fontysrobotics/DCRC/Physical_System/Solidworks_Parts/Renders/exploded view.jpg

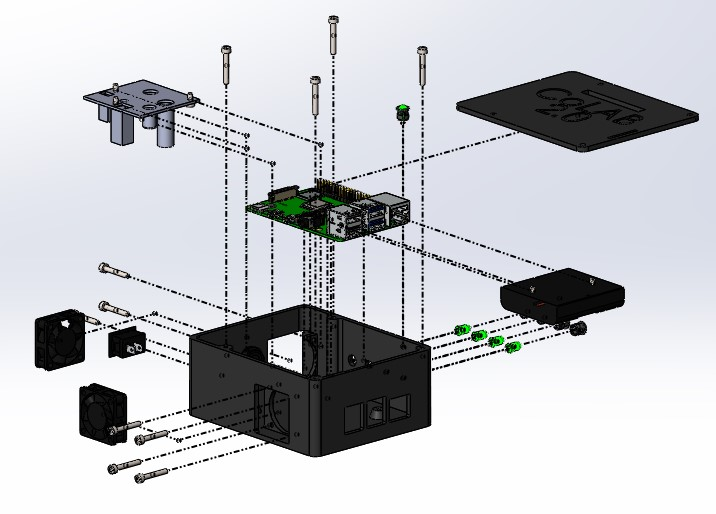
Physical_System/Solidworks_Parts/Renders/exploded view.jpg
