fontysrobotics/DCRC/Reports/Obstacle Avoidance System.pdf

# Obstacle/Crash Avoidance Feature

## DCRC Project

## Safety Course Level 3

Background and Current Situation are explained in previous document!

Execution:

The obstacle avoidance feature was created in order to recognize if there is going to be a crash between two robots and prevent it. Because this goal is too broad, I have set the scope together with our project mentor Pablo as follows:

Two robots are facing each other and going in each other’s direction along the X axis.

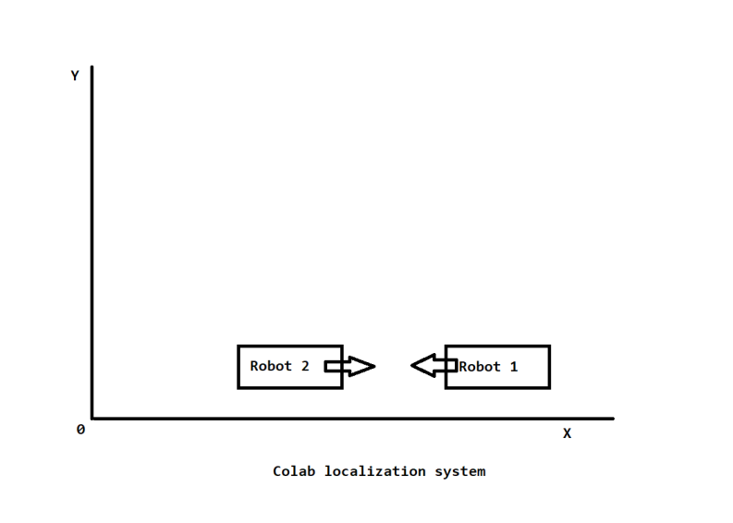
[picture p30: figure]

The goal of the test case is to detect an obstacle via the lidar and compare the lidar data to the colab list of AGVs, which contains the distance to each AGV and the angle to each of them. So each robot has that list and knows the distance to all the other and the angle to all the other. By comparing that to the lidar we know if what is in front of us is actually a robot and which exact robot it is. When the robots “see” that there is another robot in front of them they stop and compare their tasks’ priorities. The robot with the higher priority waits and the one with the lower gets a new goal to move along the Y axis so it can get out of the way. After the robot with the lower priority task gets out of the way the other robot continues on its path and the robot with the lower priority is given back its original goal and it continues on its way. In this way we prevent a crash and have a system for managing robot coordination for that particular test case.

The way the feature works is that the robots are subscribed to their Lidar and get the data of their surroundings. Because I defined the test case as the two robots facing each other, in the Lidar callback method I check if the distance to the nearest object at the 0th angle is less than 5 centimeters, meaning that we check for an obstacle in front of the robot that is nearer than half a meter. Once we find such an obstacle, the robot has to define if the obstacle in front of it is another robot and that is done by getting the list of AGVs from the colab localization software via TCP and filtering those, which are in radius of 0.5 meters. After that the robot checks if the robots that are in this radius are within a 5 degrees range of the front of the robot to filter the list further. If there is a robot in that satisfies those two conditions then the conclusion is that the obstacle in front is a robot. In order to prevent a crash the robots uses the emergency stop to pause its task and stop in place. After that the robot gets the priority of the task of the robot in front of it and its own task priority, which is done with the help of topics. The information about the priorities comes from the blackboard and if the robot has a greater priority than the one in front of it, it waits for a while. If the robot has a lower priority than the one in front of it then it is given a new temporary goal to move along the Y axis in order to make space for the other robot to pass. After it has reached the temporary goal then the robot is given again its original goal and it continues on its path and in that way both robots have avoided a crash. The sequence diagram and screenshots of the code can be seen below:

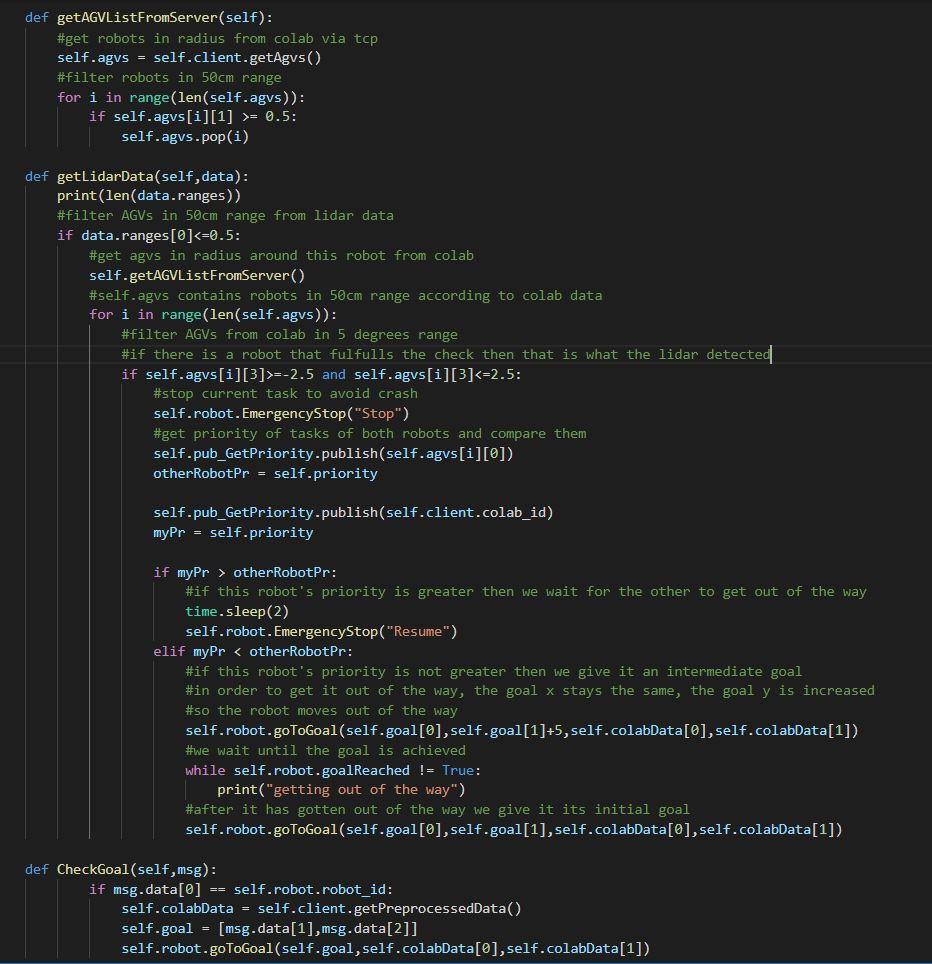
[picture p31: figure]

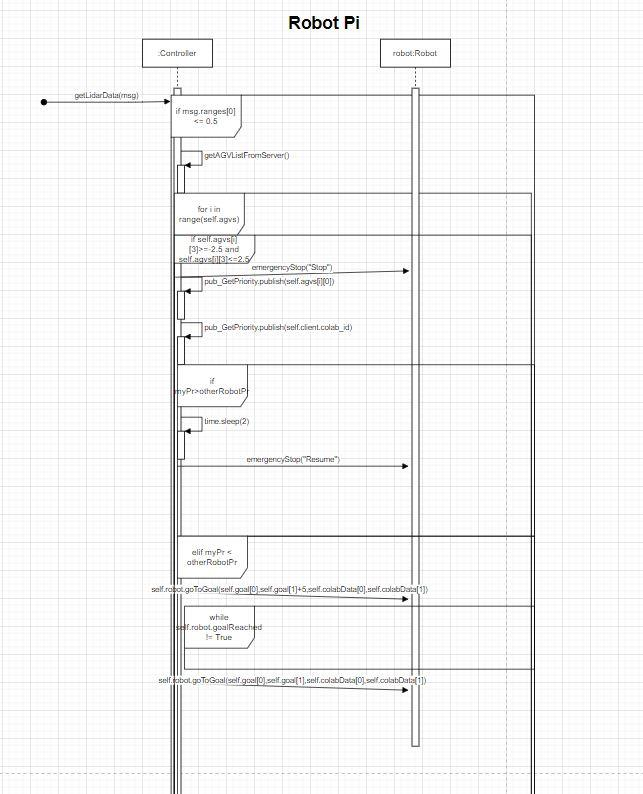
[picture p32: figure]

Result:

As I explained in the previous document, the current situation is such that the robot navigation to goal is not working on Ubuntu with ros and only works on raspbian. Furthermore, the ros bridge and ssh are not working so it is not possible to assign a task to robot. This feature too cannot be tested as in order to test even a basic version of it I will need ros2 for the lidar topic and robot navigation. This is impossible because the navigation doesn’t work on ros2 and I can’t get the lidar data without ros2 so it is a deadlock. What I decided to do in order to at least show some basic prototype is to simulate it in gazebo. I successfully got the lidar data but I couldn’t publish messages on /cmd_vel to the turtlebot3 for some reason and therefore I couldn’t make it move aside to make space for the other robot. I am confident that with a bit of debugging, the feature can be easily implemented once the issues with the GPIO library and ros are solved.

The full code for the feature can be found on: https://github.com/fontysrobotics/DCRC / The feature is only on the RobotPi branch / The TCP server and client I created can also be found in the GIT repository
