fontysrobotics/DCRC/Reports/CoLAB_StrucTree_DCRC_V2_MaxJans_3497046.png

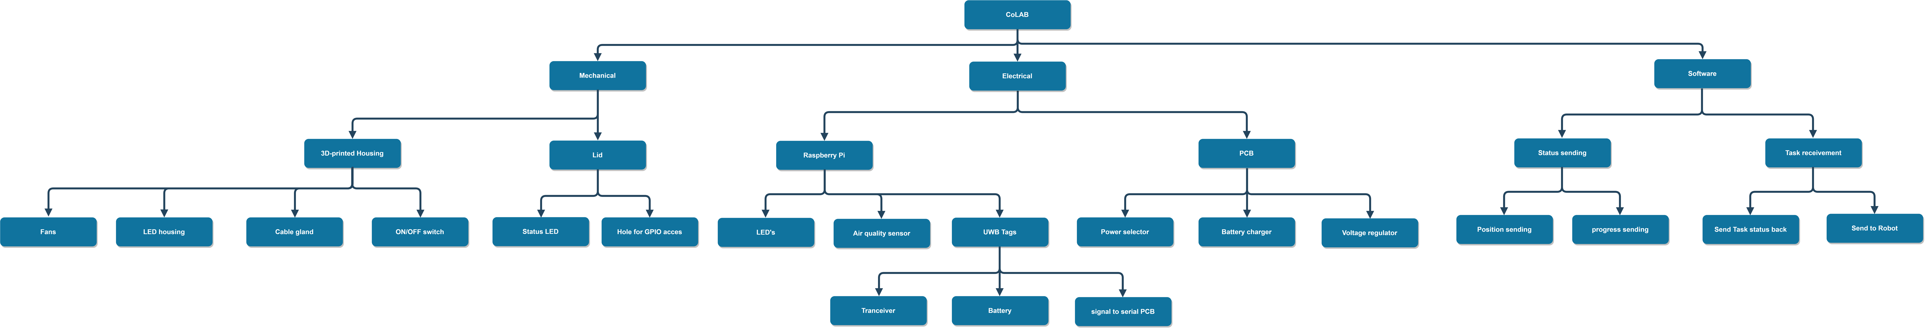
Reports/CoLAB_StrucTree_DCRC_V2_MaxJans_3497046.png
