fontysrobotics/DCRC/Wiki-Pictures/CoLAB_V2.2_PCB.png

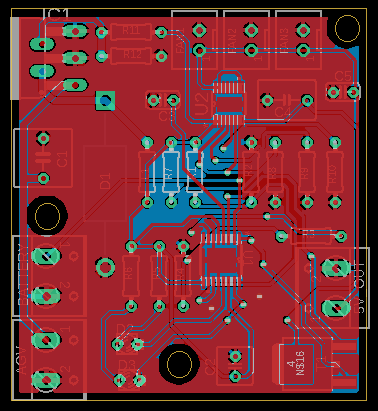
Wiki-Pictures/CoLAB_V2.2_PCB.png
