fontysrobotics/DCRC/Wiki-Pictures/CoLAB_V2_Housing.JPG

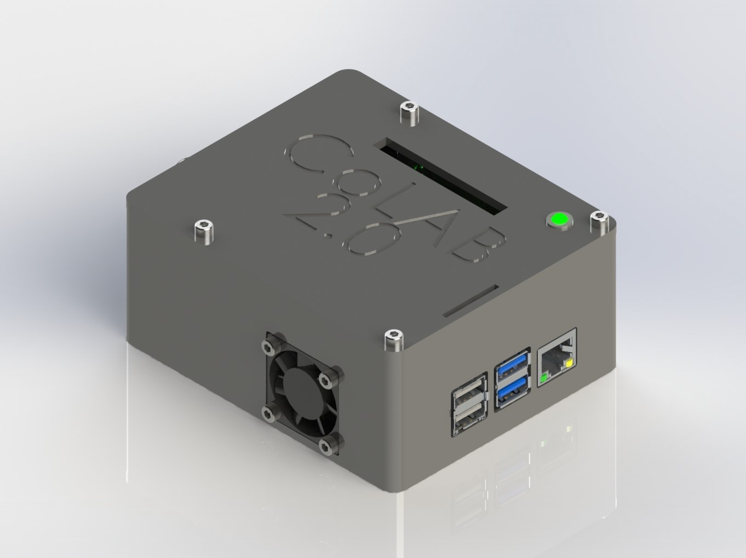
Wiki-Pictures/CoLAB_V2_Housing.JPG
