fontysrobotics/DCRC/Wiki-Pictures/CoLAB_V2_PCB.png

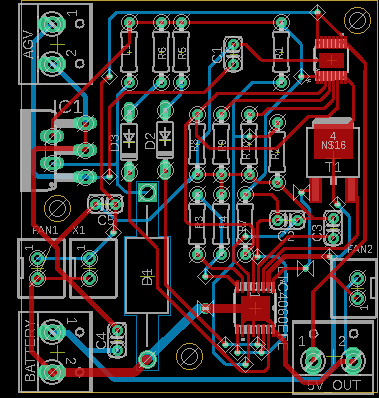
Wiki-Pictures/CoLAB_V2_PCB.png
