fontysrobotics/DCRC/Wiki-Pictures/CoLAB_V2_PCB_DC_Converter_VoltageDivider.png

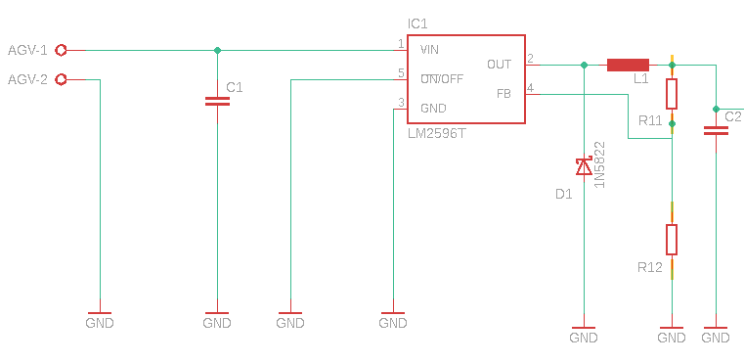
Wiki-Pictures/CoLAB_V2_PCB_DC_Converter_VoltageDivider.png
