fontysrobotics/DCRC/Wiki-Pictures/CoLAB_V2_PCB_Schematic.png

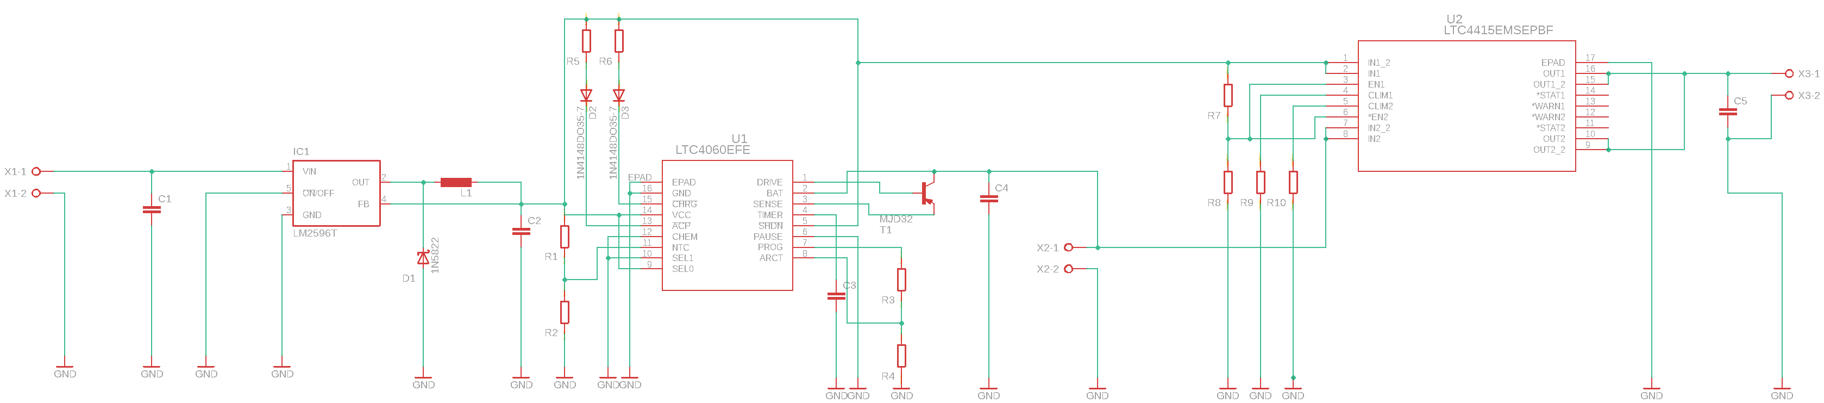
Wiki-Pictures/CoLAB_V2_PCB_Schematic.png
