fontysrobotics/DCRC/Wiki-Pictures/EmergencyStopSeqDiagram.JPG

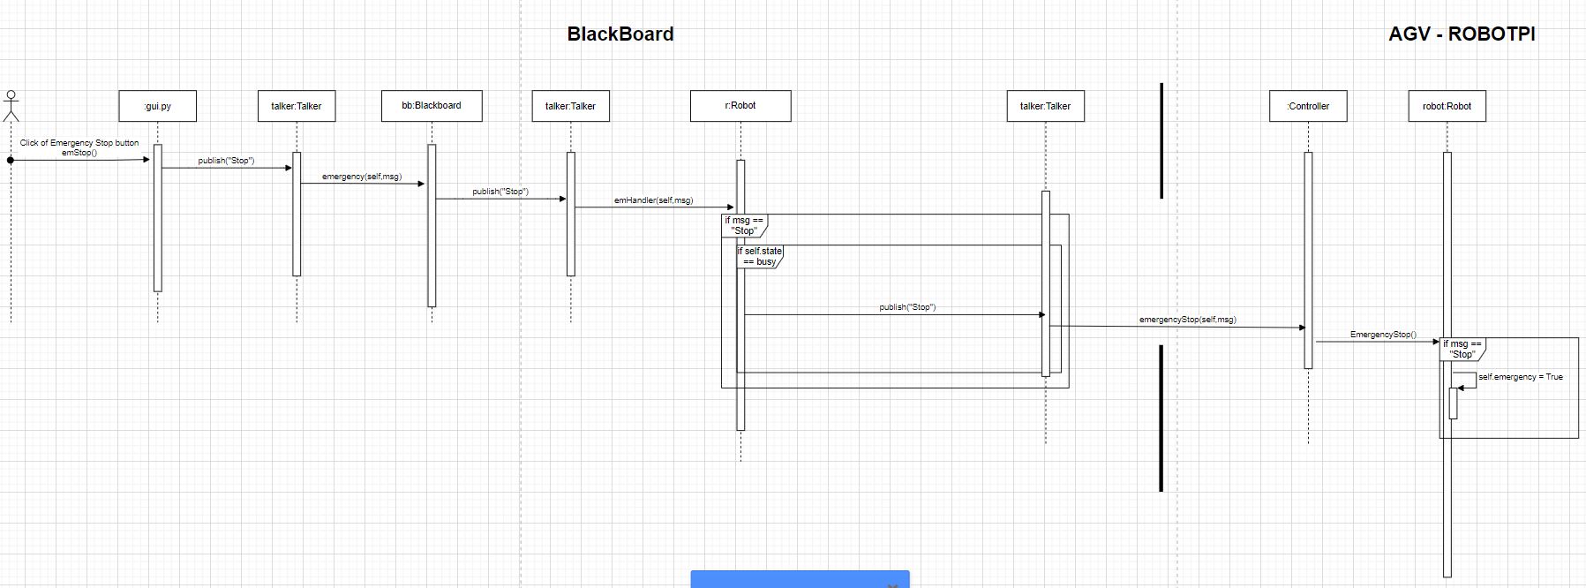
Wiki-Pictures/EmergencyStopSeqDiagram.JPG
