fontysrobotics/DCRC/Wiki-Pictures/Hollonomic car.jpeg

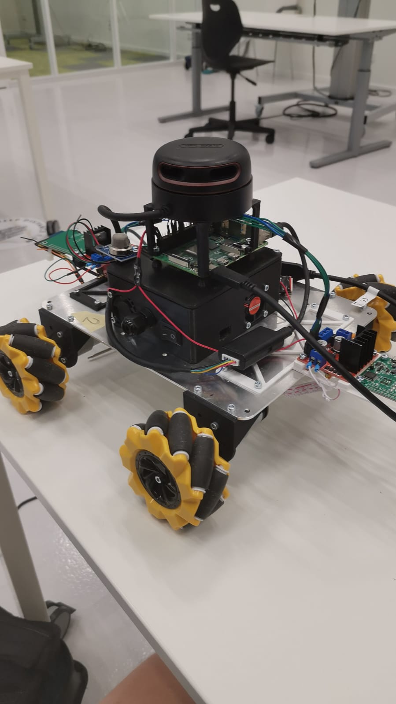
Wiki-Pictures/Hollonomic car.jpeg
