fontysrobotics/DCRC/Wiki-Pictures/ROS1 blackboard.png

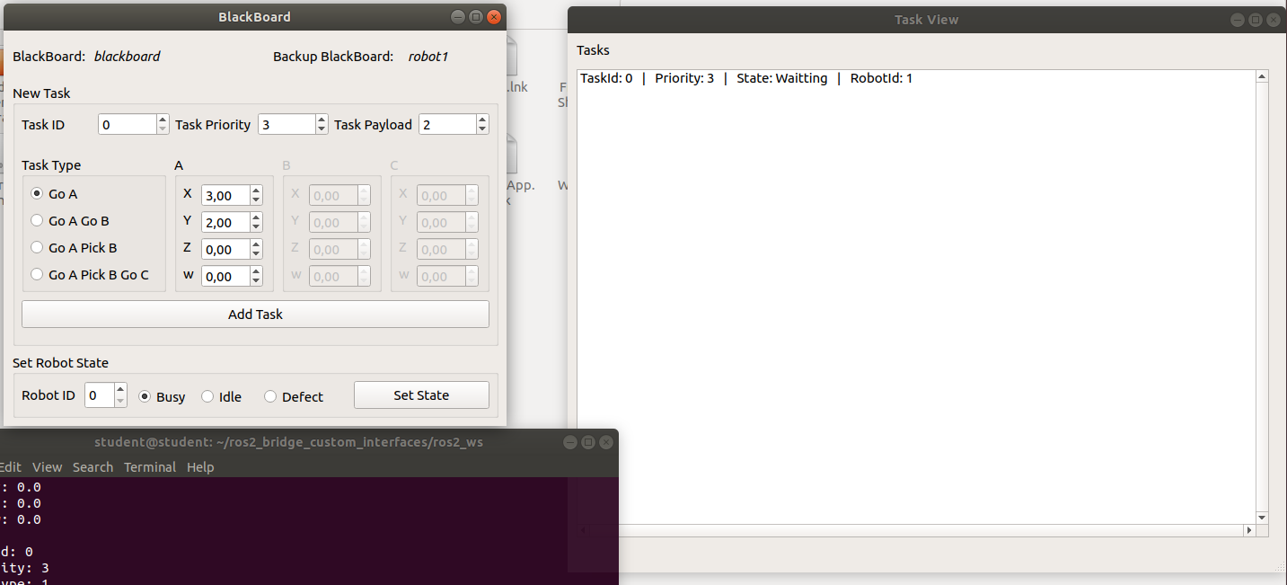
Wiki-Pictures/ROS1 blackboard.png
