fontysrobotics/DCRC/Wiki-Pictures/Ros bridge messages.png

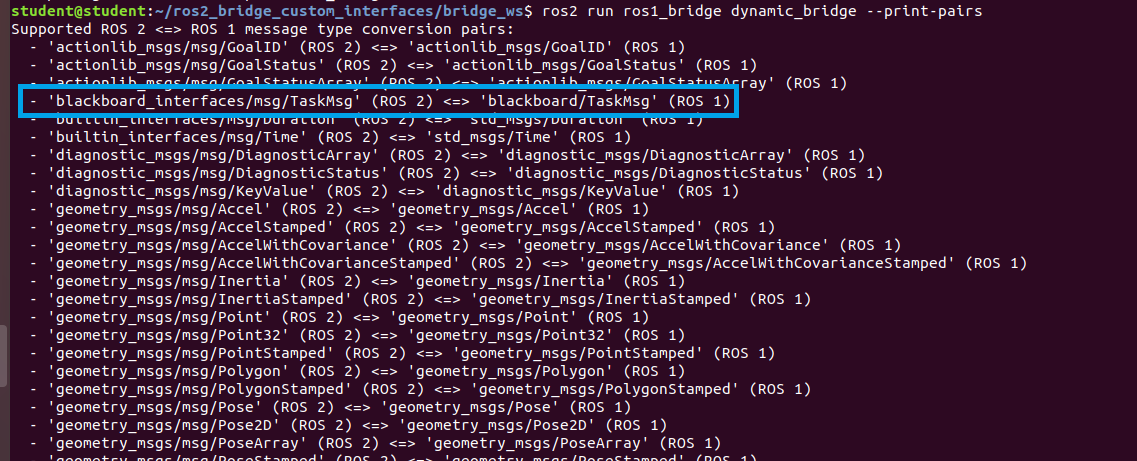
Wiki-Pictures/Ros bridge messages.png
