fontysrobotics/DCRC/Wiki-Pictures/schematic battery protection.png

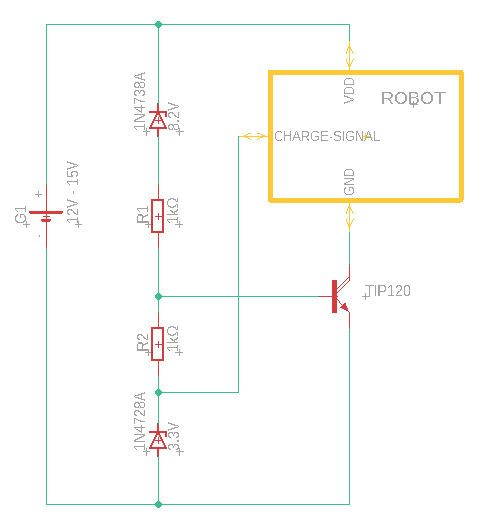
Wiki-Pictures/schematic battery protection.png
