fontysrobotics/DCRC/Wiki-Pictures/schematic LED connections.png

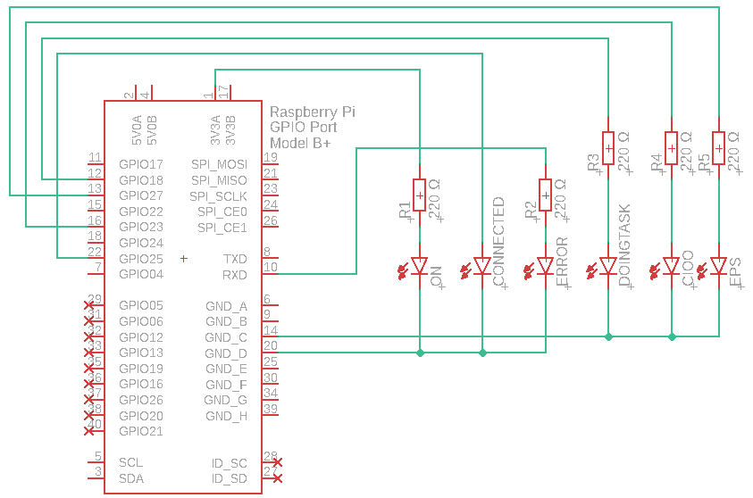
Wiki-Pictures/schematic LED connections.png
