fontysrobotics/DCRC/Physical_System/Solidworks_Parts/Renders/render colab back.JPG

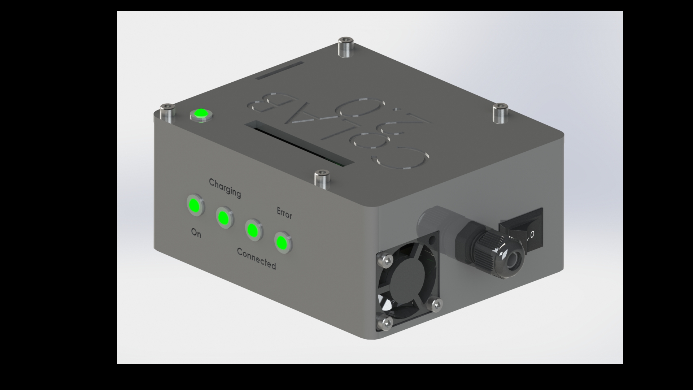
Physical_System/Solidworks_Parts/Renders/render colab back.JPG
