fontysrobotics/DCRC/Physical_System/Solidworks_Parts/Renders/render CoLAB exploded.JPG

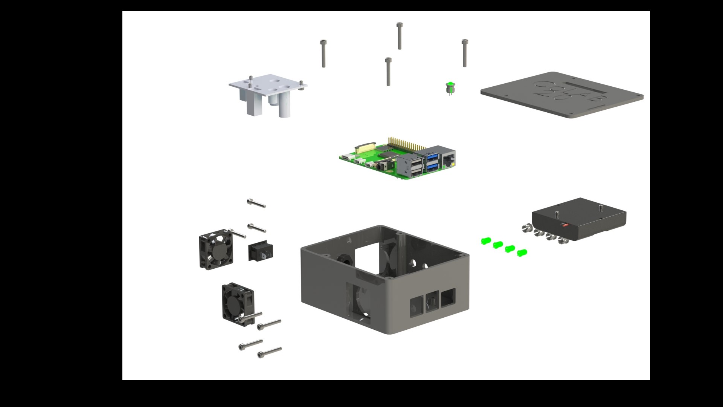
Physical_System/Solidworks_Parts/Renders/render CoLAB exploded.JPG
