fontysrobotics/DCRC/Physical_System/Solidworks_Parts/Renders/render colab front.JPG

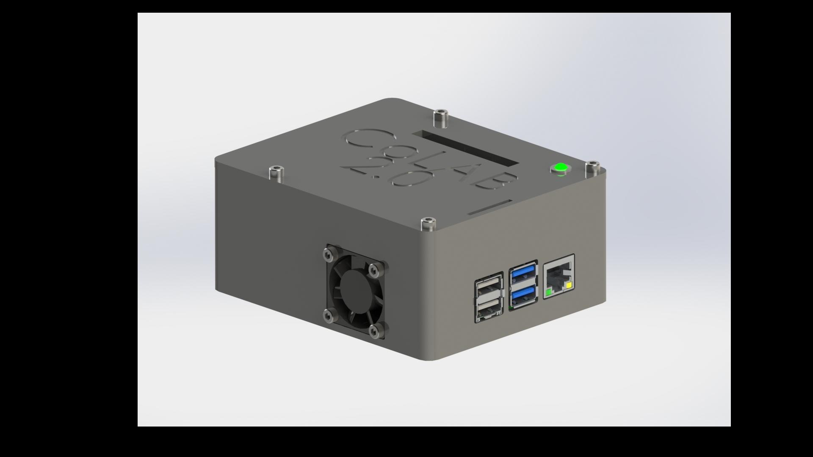
Physical_System/Solidworks_Parts/Renders/render colab front.JPG
