fontysrobotics/DCRC/Physical_System/Solidworks_Parts/Renders/render CoLAB.JPG

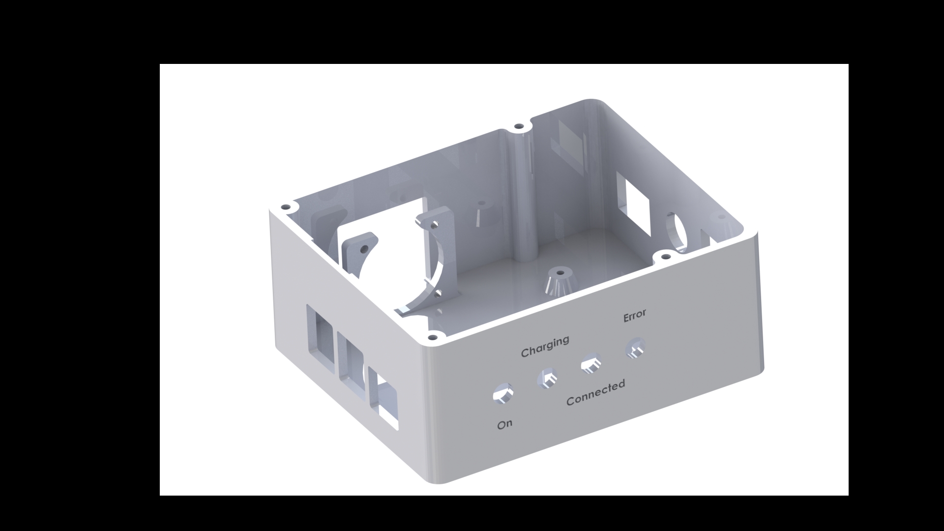
Physical_System/Solidworks_Parts/Renders/render CoLAB.JPG
