fontysrobotics/DCRC/Physical_System/Solidworks_Parts/Renders/render hole switch.JPG

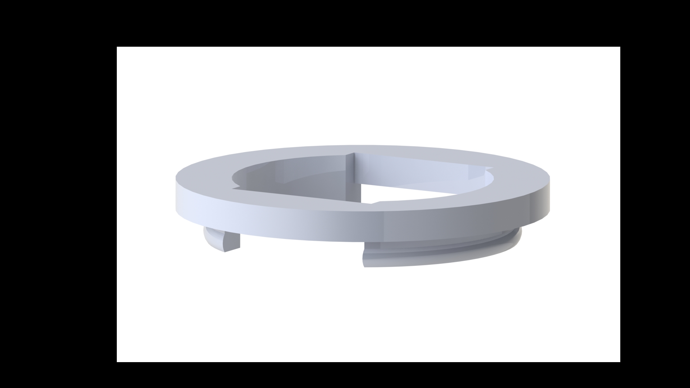
Physical_System/Solidworks_Parts/Renders/render hole switch.JPG
