fontysrobotics/DCRC/Physical_System/Solidworks_Parts/Renders/render lidar frame.JPG

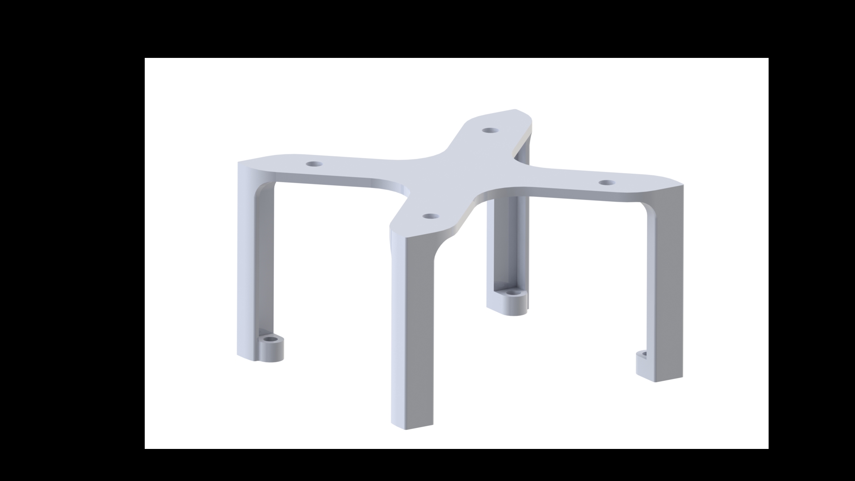
Physical_System/Solidworks_Parts/Renders/render lidar frame.JPG
