fontysrobotics/DCRC/Physical_System/Solidworks_Parts/Renders/render motor axle.JPG

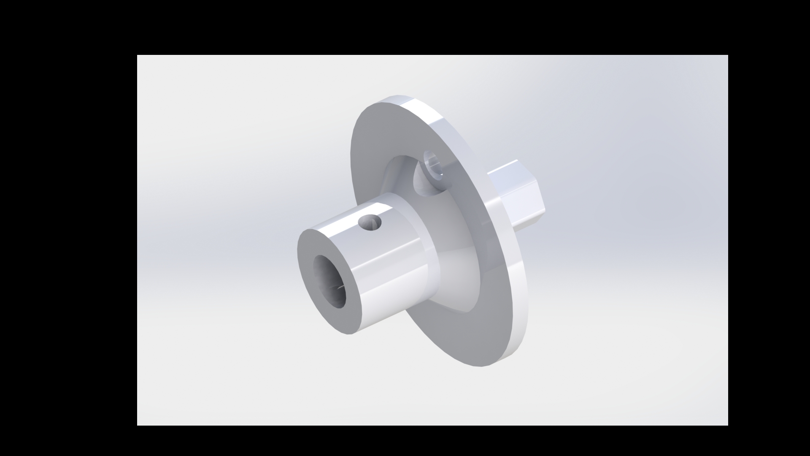
Physical_System/Solidworks_Parts/Renders/render motor axle.JPG
