fontysrobotics/DCRC/Physical_System/Solidworks_Parts/Renders/render motor mount.JPG

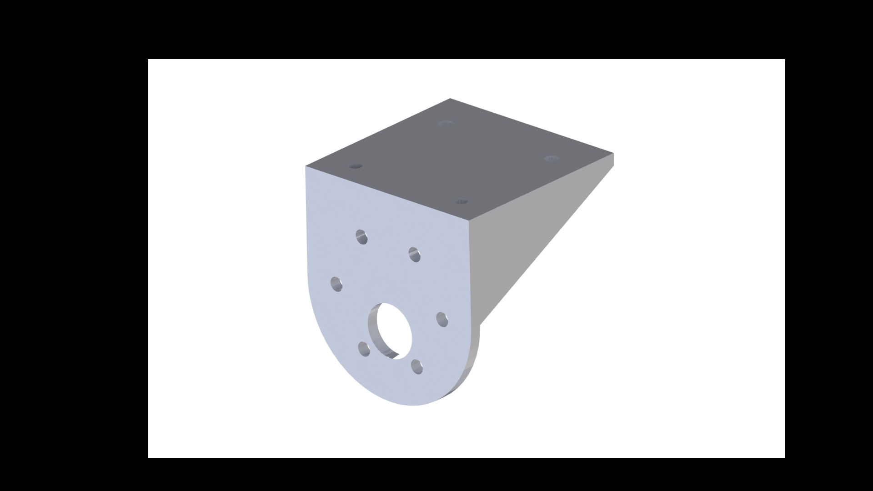
Physical_System/Solidworks_Parts/Renders/render motor mount.JPG
