fontysrobotics/DCRC/Physical_System/Solidworks_Parts/Renders/render tag holder.JPG

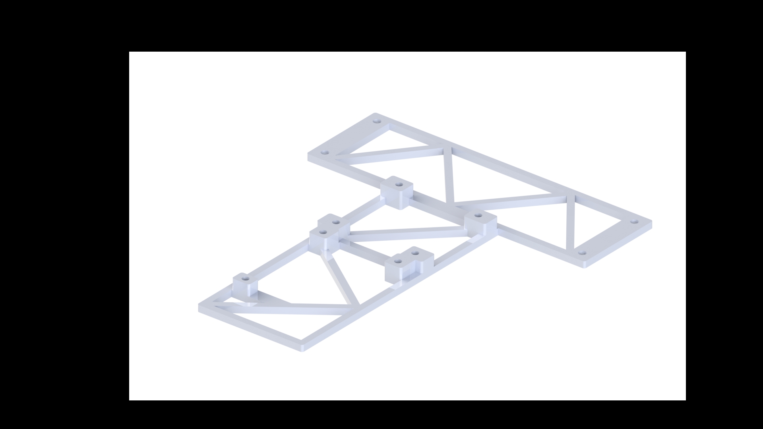
Physical_System/Solidworks_Parts/Renders/render tag holder.JPG
