fontysrobotics/DCRC/Physical_System/Solidworks_Parts/Renders/render topplate.JPG

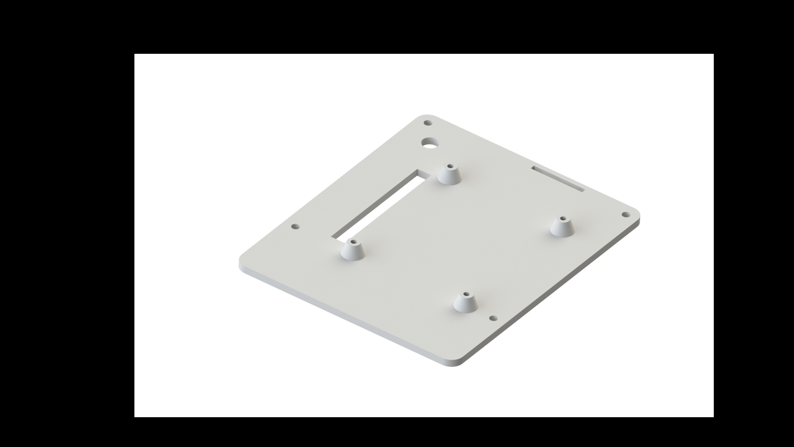
Physical_System/Solidworks_Parts/Renders/render topplate.JPG
