fontysrobotics/DCRC/Physical_System/Solidworks_Parts/CoLAB/5mm-led-grommit-1.snapshot.1/5mm-grommit-with-LED.SLDASM

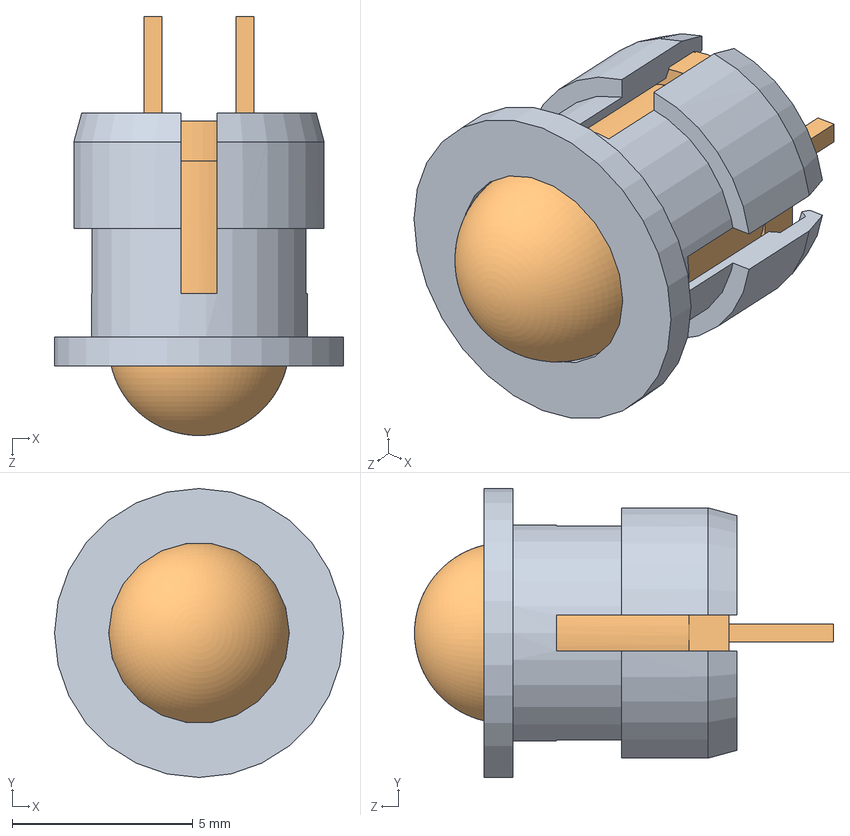
[picture p79: CAD file, 2021-07-06]
Physical_System/Solidworks_Parts/CoLAB/5mm-led-grommit-1.snapshot.1/5mm-grommit-with-LED.SLDASM
8.00 x 8.00 x 11.6 mm
5mm LED GROMMIT
Led Lamp 5 mm
