fontysrobotics/DCRC/Physical_System/Solidworks_Parts/CoLAB/led-5mm-2.snapshot.16/SolidWorks Çizimleri/Led Montaj.SLDASM

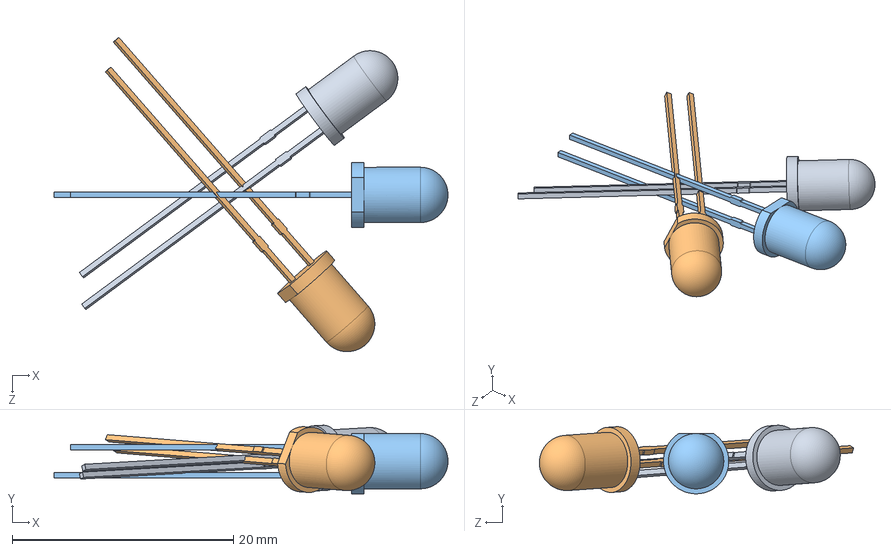
[picture p80: CAD file, 2021-07-06]
Physical_System/Solidworks_Parts/CoLAB/led-5mm-2.snapshot.16/SolidWorks Çizimleri/Led Montaj.SLDASM
35.6 x 6.19 x 28.4 mm
Led Lamp 5 mm 1(2)
Led Lamp 5 mm 2
Led Lamp 5 mm 3
