fontysrobotics/DCRC/Physical_System/Solidworks_Parts/CoLAB/CoLAB_V2_Housing.SLDASM

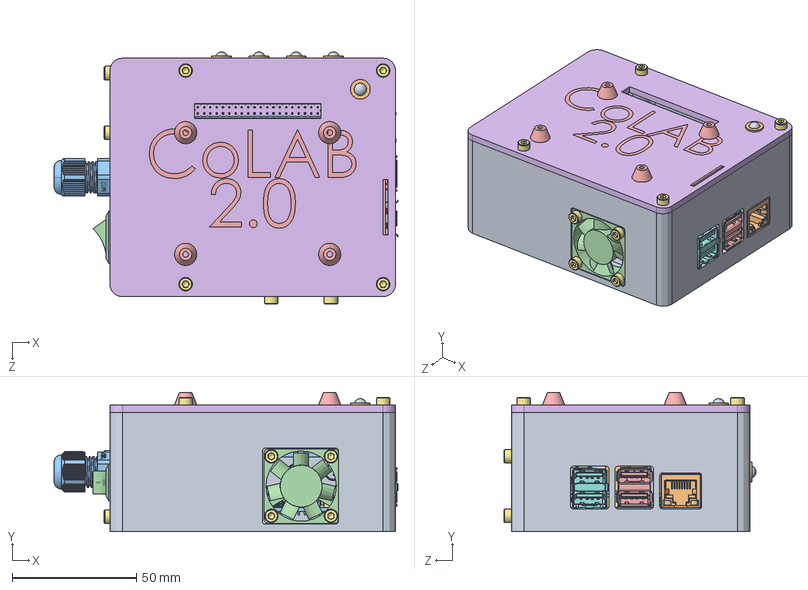
[picture p81: CAD file, 2021-07-06]
Physical_System/Solidworks_Parts/CoLAB/CoLAB_V2_Housing.SLDASM
138.5 x 56.0 x 101.5 mm
CoLAB_V2
PCBV2
Broadcom BCM2711B0 CPU, RPi4ModelB
2.54 mm DUPONT MALE PIN HEADER, POE, 2X2, RPi4ModelB
2.54 mm DUPONT MALE PIN HEADER, IO, 2X20, RPi4ModelB
Camera Connector, RPi4ModelB
Microphone Plug, RPi4ModelB
Display Connector, RPi4ModelB
Gigabit Ethernet Port, RPi4ModelB
Female Micro HDMI Connector, RPi4ModelB x 2
Female USB Type C Connector, RPi4ModelB
2X USB3.0 PORTS, RPi4ModelB
91D77 D9WHV 778K, 4 GB LPDDR4 SDRAM, RPi4ModelB
Cypress CYW43455 Wireless Module Cover, RPi4ModelB
2X USB2.0 PORTS, RPi4ModelB
Broadcom BCM54213PE Gigabit Ethernet Transceiver, RPi4ModelB
MxL7704 Universal PMIC, RPi4ModelB
AAA-battery-x4-case
30X30X10 DC fan x 2
CoLAB_Topplate_V2_GPIOacces
socket head cap screw_am x 16
socket countersunk head screw_am x 2
Led Lamp 5 mm x 5
5mm LED GROMMIT x 5
gland_m12
RockerSwitch
