fontysrobotics/DCRC/catkin_ws/src/simulation/rviz_tools_py-master/meshes/box_mesh.stl

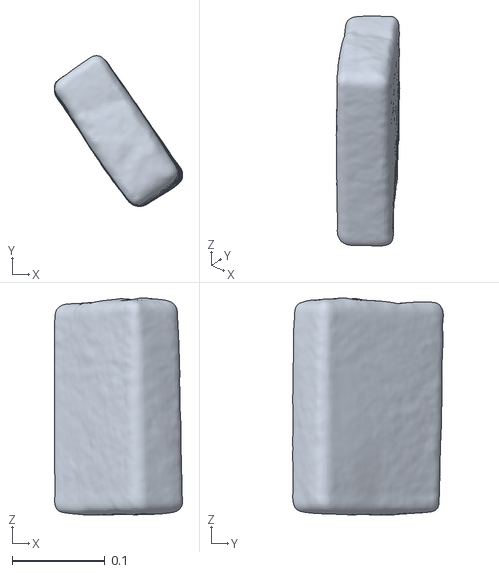
[picture p82: CAD file, 2021-07-06]
catkin_ws/src/simulation/rviz_tools_py-master/meshes/box_mesh.stl
0.139 x 0.163 x 0.234
