fontysrobotics/DCRC/catkin_ws/src/simulation/simenv/worlds/en.stl

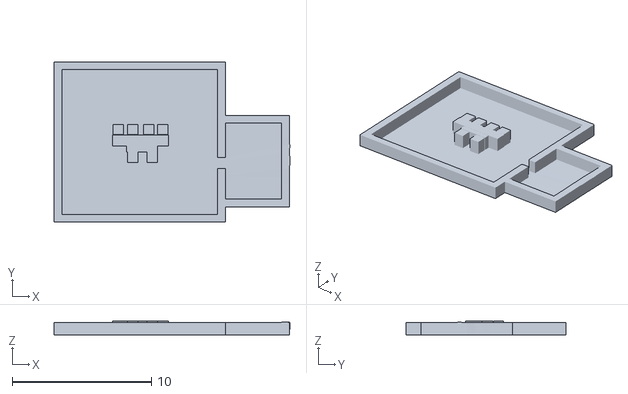
[picture p83: CAD file, 2021-07-06]
catkin_ws/src/simulation/simenv/worlds/en.stl
16.9 x 11.5 x 1.00
