fontysrobotics/DCRC/catkin_ws/src/simulation/turtlebot3_description/meshes/sensors/lds.stl

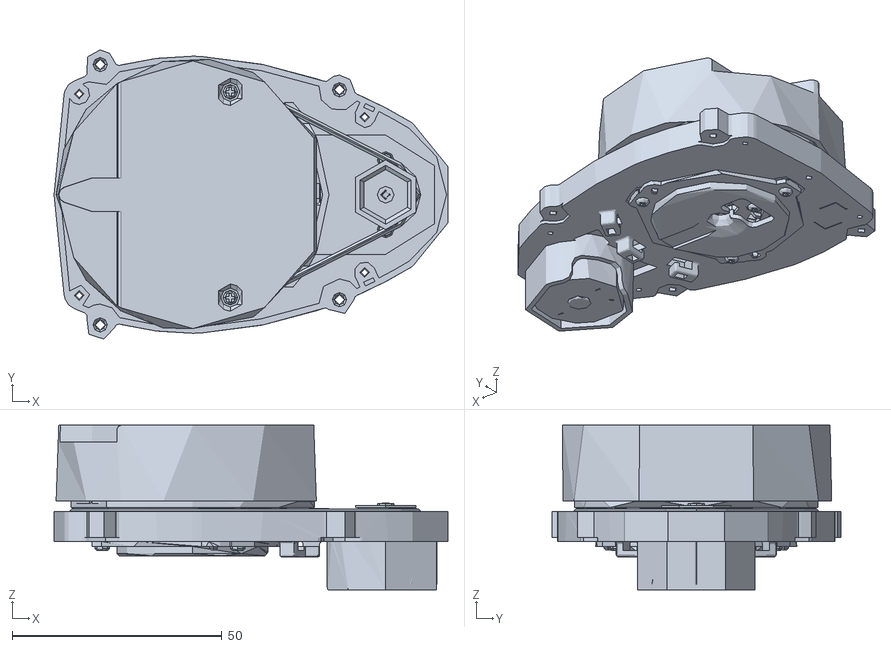
[picture p84: CAD file, 2021-07-06]
catkin_ws/src/simulation/turtlebot3_description/meshes/sensors/lds.stl
93.8 x 68.9 x 39.2
