fontysrobotics/DCRC/catkin_ws/src/simulation/turtlebot3_description/meshes/wheels/left_tire.stl

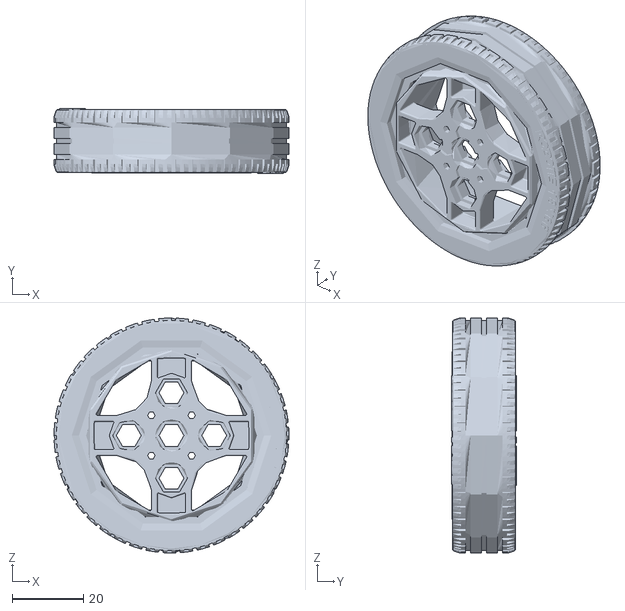
[picture p85: CAD file, 2021-07-06]
catkin_ws/src/simulation/turtlebot3_description/meshes/wheels/left_tire.stl
66.0 x 18.2 x 66.0
