fontysrobotics/DCRC/Physical_System/Solidworks_Parts/CoLAB/30mm-dc-fan-1.snapshot.6/30X30X10 DC fan .step

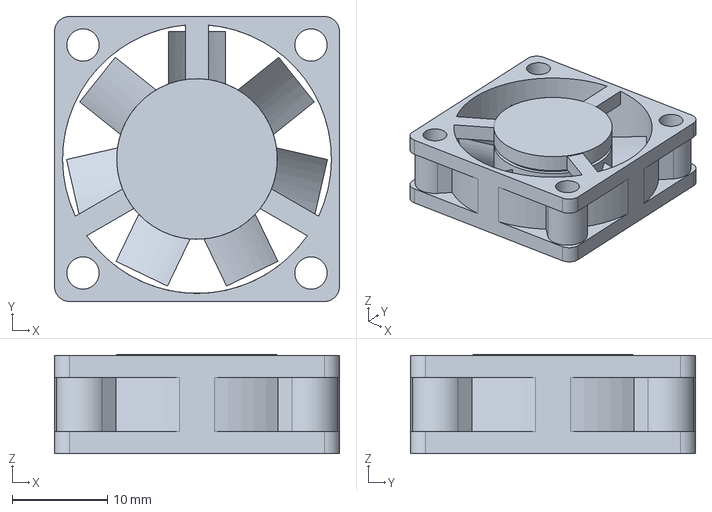
[picture p86: CAD file, 2021-07-06]
Physical_System/Solidworks_Parts/CoLAB/30mm-dc-fan-1.snapshot.6/30X30X10 DC fan .step
30.0 x 30.0 x 10.4 mm
