fontysrobotics/DCRC/Physical_System/Solidworks_Parts/CoLAB/5mm-led-grommit-1.snapshot.1/5mm LED GROMMIT.stp

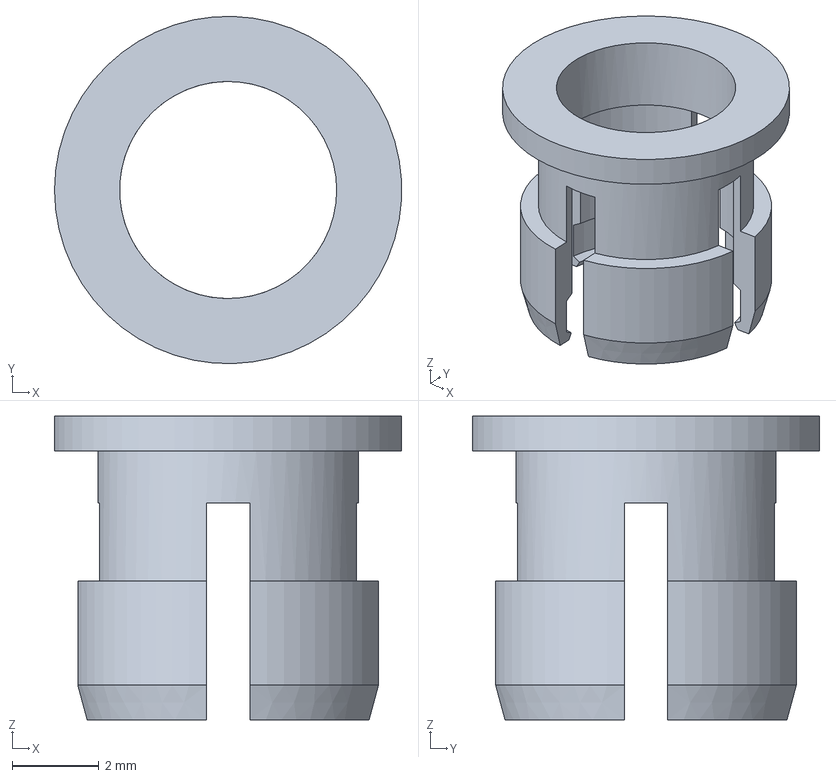
[picture p87: CAD file, 2021-07-06]
Physical_System/Solidworks_Parts/CoLAB/5mm-led-grommit-1.snapshot.1/5mm LED GROMMIT.stp
7.99 x 8.00 x 7.00 mm
