fontysrobotics/DCRC/Physical_System/Solidworks_Parts/CoLAB/AAA battery holder/AAA-battery-x4-case.step

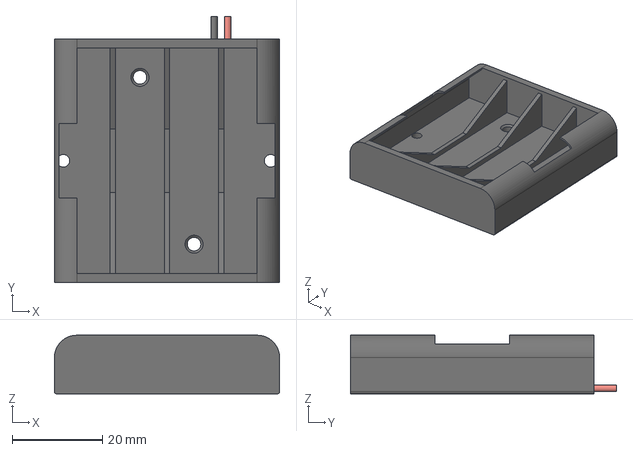
[picture p88: CAD file, 2021-07-06]
Physical_System/Solidworks_Parts/CoLAB/AAA battery holder/AAA-battery-x4-case.step
50.0 x 59.0 x 13.0 mm
