fontysrobotics/DCRC/Physical_System/Solidworks_Parts/CoLAB/CoLAB_Topplate_V2_GPIOacces.SLDPRT

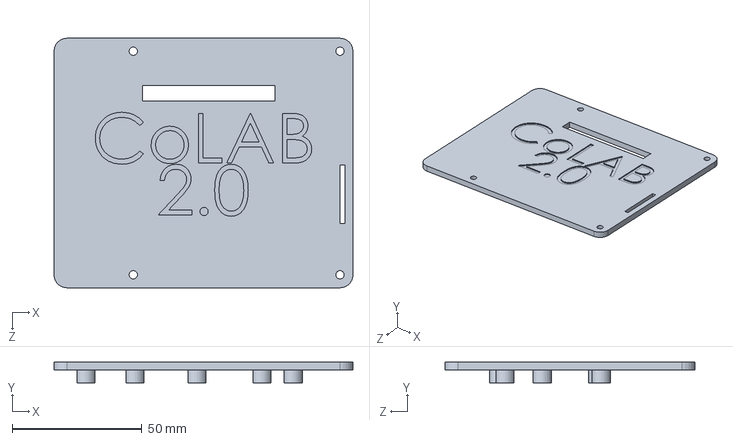
[picture p89: CAD file, 2021-07-06]
Physical_System/Solidworks_Parts/CoLAB/CoLAB_Topplate_V2_GPIOacces.SLDPRT
115.0 x 8.00 x 96.0 mm
