fontysrobotics/DCRC/Physical_System/Solidworks_Parts/CoLAB/led-5mm-2.snapshot.16/Led Lamp 5 mm.SLDPRT

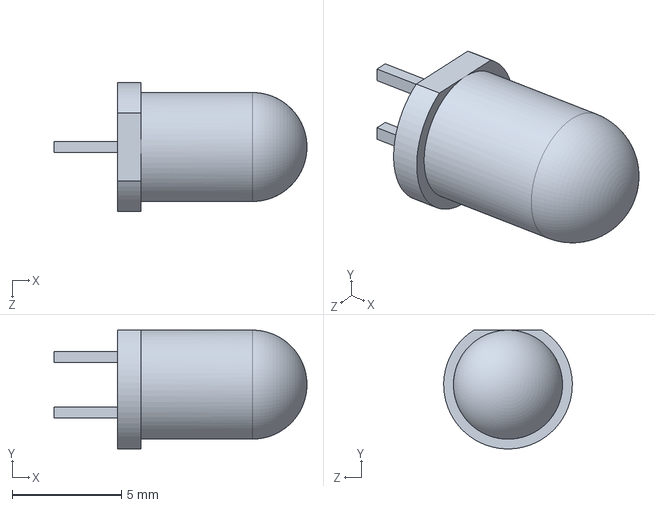
[picture p90: CAD file, 2021-07-06]
Physical_System/Solidworks_Parts/CoLAB/led-5mm-2.snapshot.16/Led Lamp 5 mm.SLDPRT
11.6 x 5.45 x 5.90 mm
