fontysrobotics/DCRC/Physical_System/Solidworks_Parts/CoLAB/led-5mm-2.snapshot.16/SolidWorks Çizimleri/Led Lamp 5 mm 3.SLDPRT

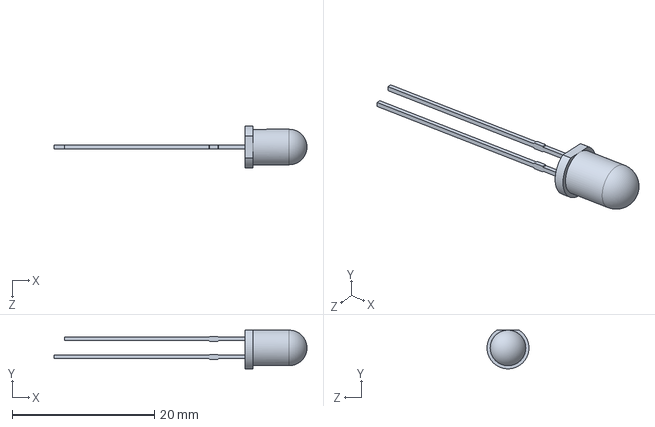
[picture p91: CAD file, 2021-07-06]
Physical_System/Solidworks_Parts/CoLAB/led-5mm-2.snapshot.16/SolidWorks Çizimleri/Led Lamp 5 mm 3.SLDPRT
35.6 x 5.45 x 5.90 mm
