fontysrobotics/DCRC/Physical_System/Solidworks_Parts/CoLAB/m12-cable-gland-1.snapshot.1/gland_m12.stp

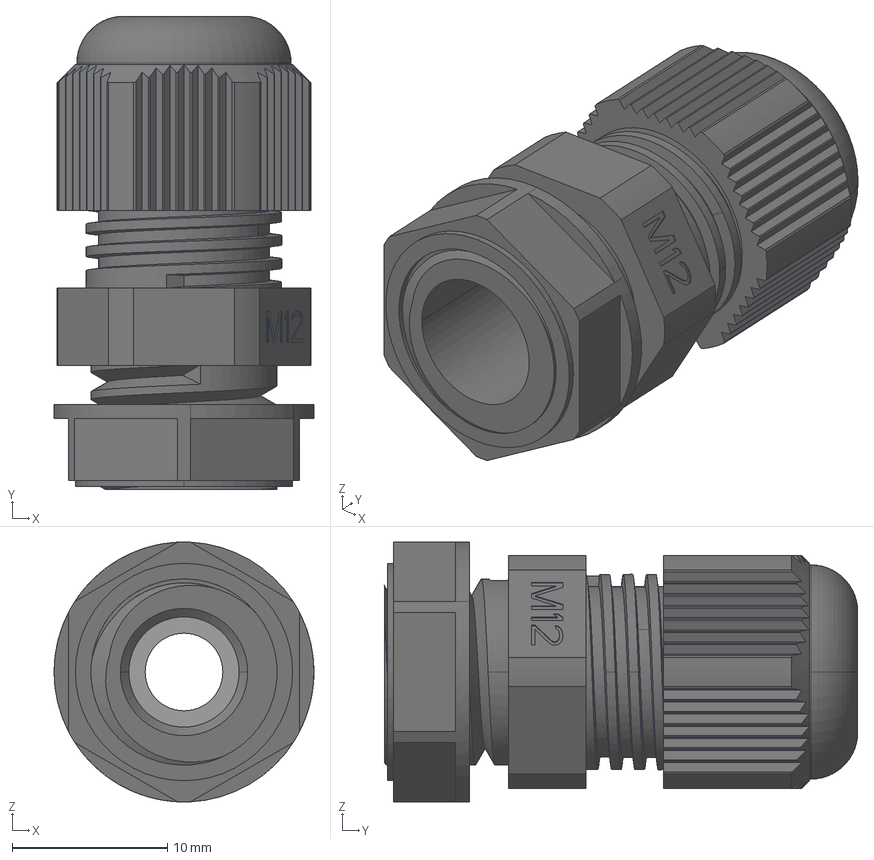
[picture p92: CAD file, 2021-07-06]
Physical_System/Solidworks_Parts/CoLAB/m12-cable-gland-1.snapshot.1/gland_m12.stp
16.8 x 30.5 x 16.7 mm
