fontysrobotics/DCRC/Physical_System/Solidworks_Parts/CoLAB/raspberry-pi-4-model-b-1.snapshot.3/2X USB2.0 PORTS, RPi4ModelB.SLDPRT

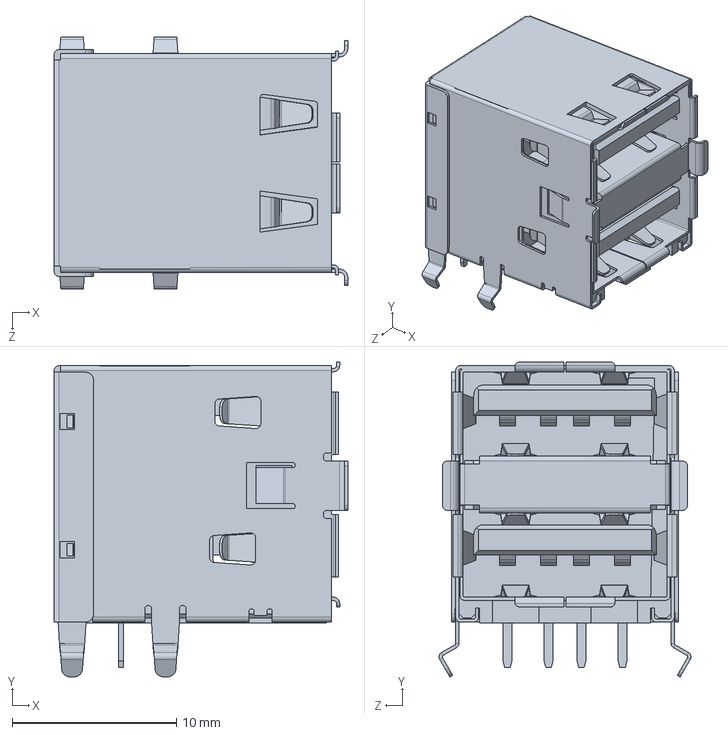
[picture p93: CAD file, 2021-07-06]
Physical_System/Solidworks_Parts/CoLAB/raspberry-pi-4-model-b-1.snapshot.3/2X USB2.0 PORTS, RPi4ModelB.SLDPRT
17.9 x 19.2 x 15.3 mm
