fontysrobotics/DCRC/Physical_System/Solidworks_Parts/Holonomic car/MotorShield + UWB tag mount V2.SLDPRT

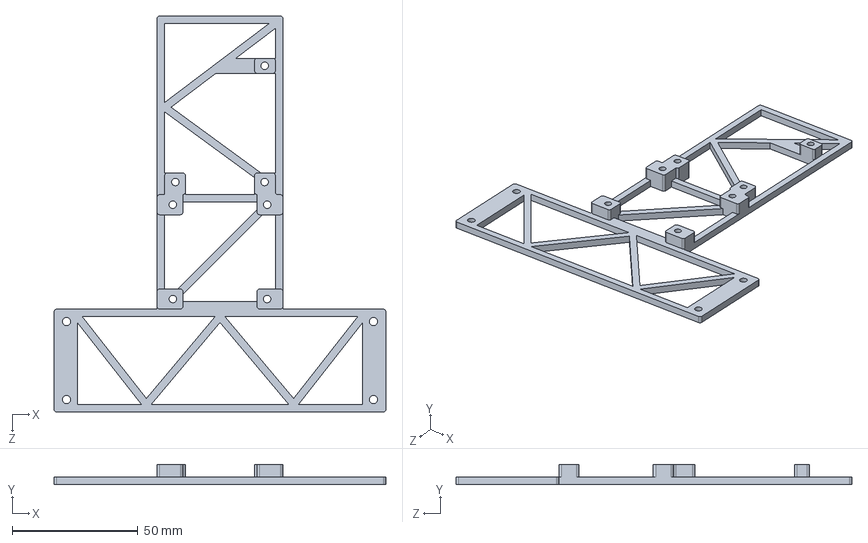
[picture p94: CAD file, 2021-07-06]
Physical_System/Solidworks_Parts/Holonomic car/MotorShield + UWB tag mount V2.SLDPRT
131.9 x 8.00 x 157.4 mm
