fontysrobotics/DCRC/catkin_ws/src/simulation/rviz_tools_py-master/meshes/fuze_bottle_collision.stl

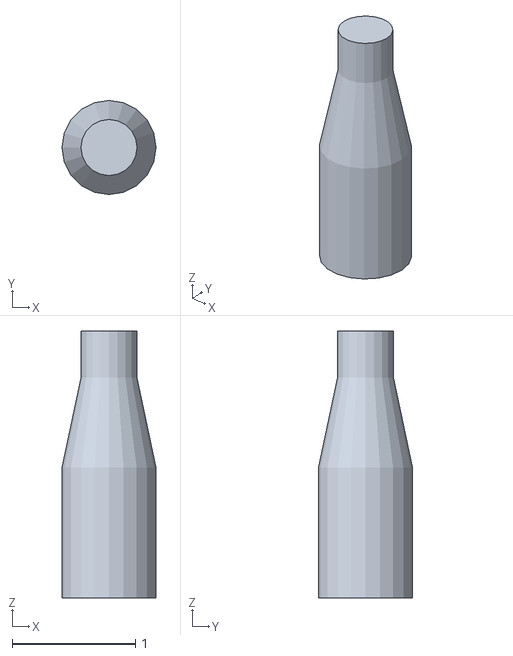
[picture p95: CAD file, 2021-07-06]
catkin_ws/src/simulation/rviz_tools_py-master/meshes/fuze_bottle_collision.stl
0.763 x 0.763 x 2.16
