fontysrobotics/DCRC/Physical_System/Solidworks_Parts/CoLAB/CoLAB_V2.SLDPRT

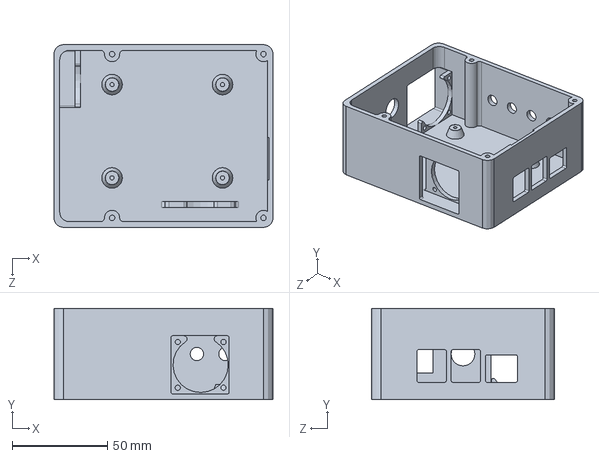
[picture p96: CAD file, 2021-07-06]
Physical_System/Solidworks_Parts/CoLAB/CoLAB_V2.SLDPRT
115.0 x 48.0 x 96.0 mm
