fontysrobotics/DCRC/Physical_System/Solidworks_Parts/CoLAB/raspberry-pi-4-model-b-1.snapshot.3/Display Connector, RPi4ModelB.SLDPRT

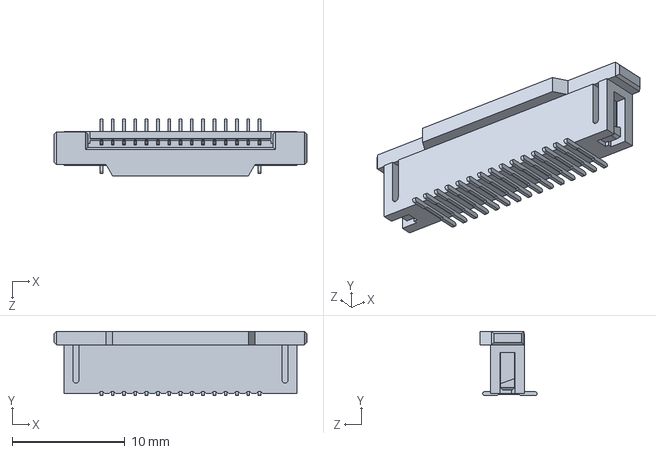
[picture p97: CAD file, 2021-07-06]
Physical_System/Solidworks_Parts/CoLAB/raspberry-pi-4-model-b-1.snapshot.3/Display Connector, RPi4ModelB.SLDPRT
22.4 x 5.68 x 5.07 mm
