fontysrobotics/DCRC/Physical_System/Solidworks_Parts/Holonomic car/lidar frame.SLDPRT

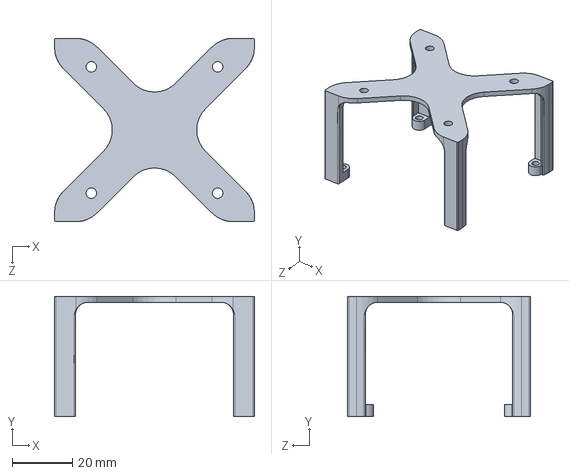
[picture p98: CAD file, 2021-07-06]
Physical_System/Solidworks_Parts/Holonomic car/lidar frame.SLDPRT
66.5 x 40.0 x 61.0 mm
