fontysrobotics/DCRC/Physical_System/Solidworks_Parts/CoLAB/CoLAB_Topplate_V2.SLDPRT

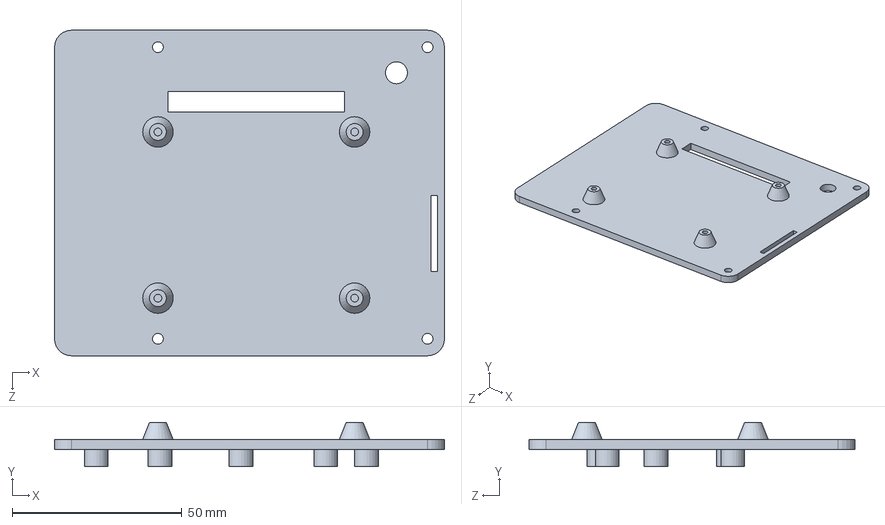
[picture p99: CAD file, 2021-07-06]
Physical_System/Solidworks_Parts/CoLAB/CoLAB_Topplate_V2.SLDPRT
115.0 x 13.0 x 96.0 mm
