fontysrobotics/DCRC/Physical_System/Solidworks_Parts/CoLAB/raspberry-pi-4-model-b-1.snapshot.3/2X USB3.0 PORTS, RPi4ModelB.SLDPRT

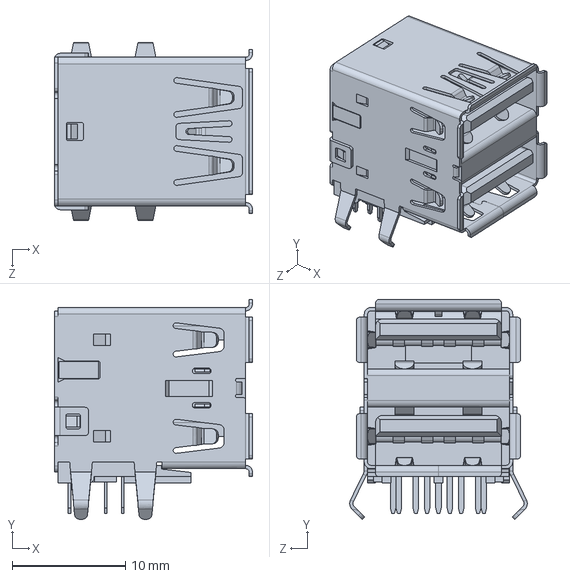
[picture p100: CAD file, 2021-07-06]
Physical_System/Solidworks_Parts/CoLAB/raspberry-pi-4-model-b-1.snapshot.3/2X USB3.0 PORTS, RPi4ModelB.SLDPRT
17.5 x 19.4 x 15.7 mm
