fontysrobotics/DCRC/Physical_System/Solidworks_Parts/Holonomic car/motor mount.SLDPRT

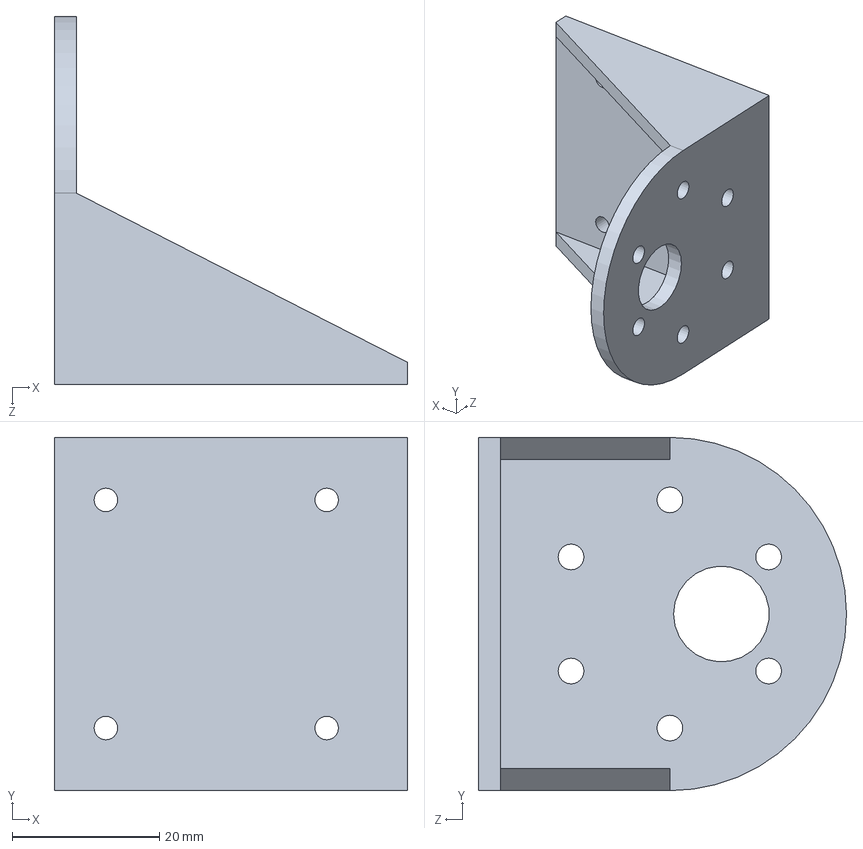
[picture p101: CAD file, 2021-07-06]
Physical_System/Solidworks_Parts/Holonomic car/motor mount.SLDPRT
48.0 x 48.0 x 50.0 mm
