fontysrobotics/DCRC/Physical_System/Solidworks_Parts/CoLAB/raspberry-pi-4-model-b-1.snapshot.3/PCB, RPi4ModelB.SLDPRT

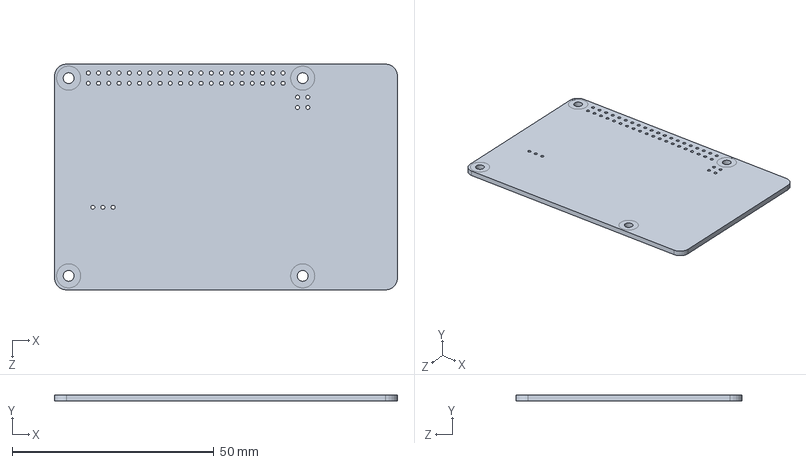
[picture p102: CAD file, 2021-07-06]
Physical_System/Solidworks_Parts/CoLAB/raspberry-pi-4-model-b-1.snapshot.3/PCB, RPi4ModelB.SLDPRT
85.0 x 1.60 x 56.0 mm
