fontysrobotics/DCRC/Physical_System/Solidworks_Parts/CoLAB/RockerSwitch.SLDPRT

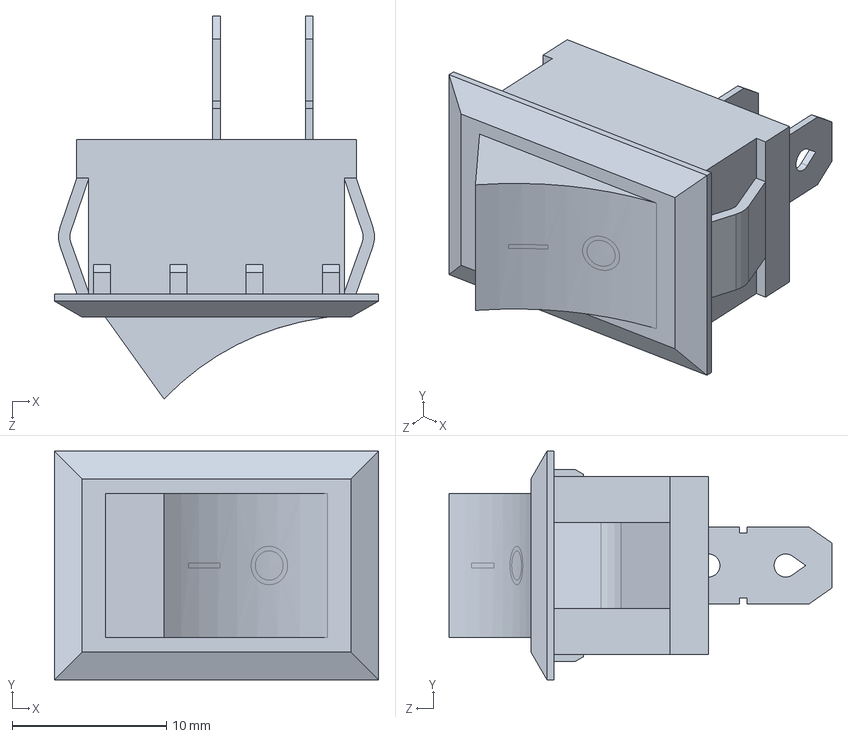
[picture p103: CAD file, 2021-07-06]
Physical_System/Solidworks_Parts/CoLAB/RockerSwitch.SLDPRT
21.0 x 14.8 x 24.8 mm
