fontysrobotics/DCRC/Physical_System/Solidworks_Parts/Holonomic car/adapter motor wheel.SLDPRT

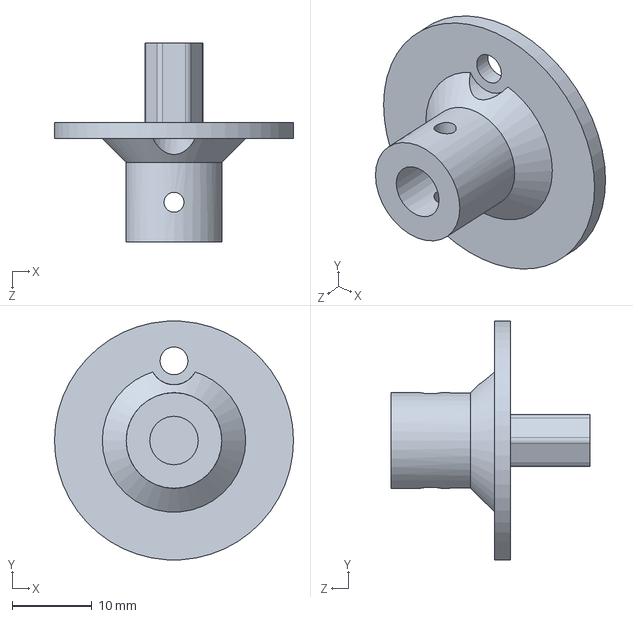
[picture p104: CAD file, 2021-07-06]
Physical_System/Solidworks_Parts/Holonomic car/adapter motor wheel.SLDPRT
30.0 x 29.9 x 25.0 mm
