fontysrobotics/DCRC/Physical_System/Solidworks_Parts/CoLAB/PCBV2.SLDPRT

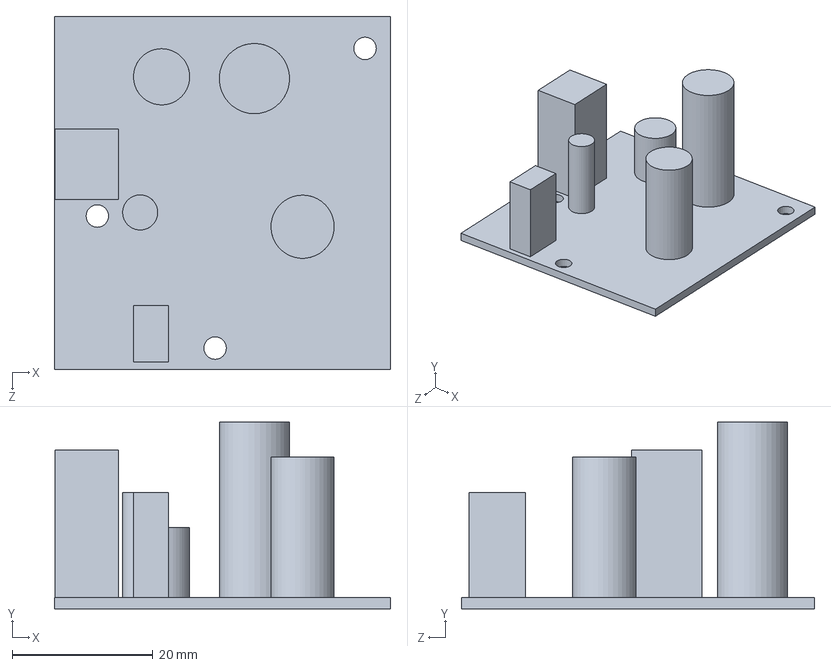
[picture p105: CAD file, 2021-07-06]
Physical_System/Solidworks_Parts/CoLAB/PCBV2.SLDPRT
47.8 x 26.6 x 50.2 mm
