fontysrobotics/DCRC/Physical_System/Solidworks_Parts/CoLAB/raspberry-pi-4-model-b-1.snapshot.3/Microphone Plug, RPi4ModelB.SLDPRT

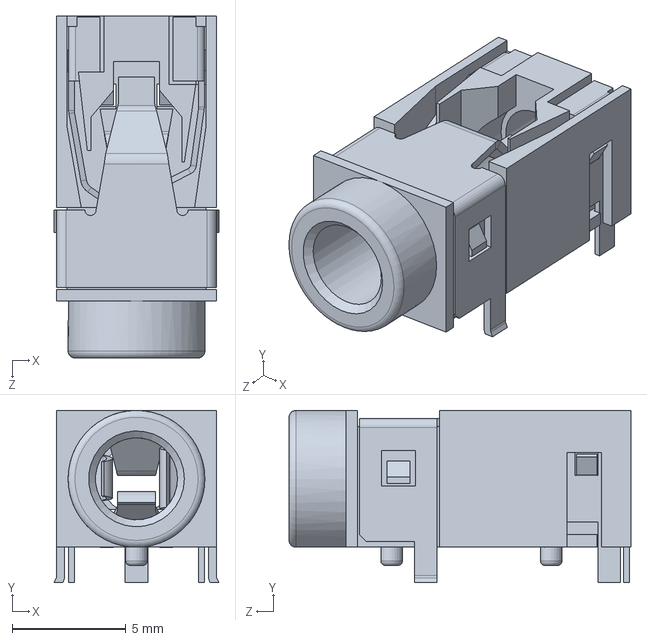
[picture p106: CAD file, 2021-07-06]
Physical_System/Solidworks_Parts/CoLAB/raspberry-pi-4-model-b-1.snapshot.3/Microphone Plug, RPi4ModelB.SLDPRT
7.23 x 7.55 x 15.0 mm
