fontysrobotics/DCRC/Physical_System/Solidworks_Parts/Holonomic car/HoleSwitchV2.SLDPRT

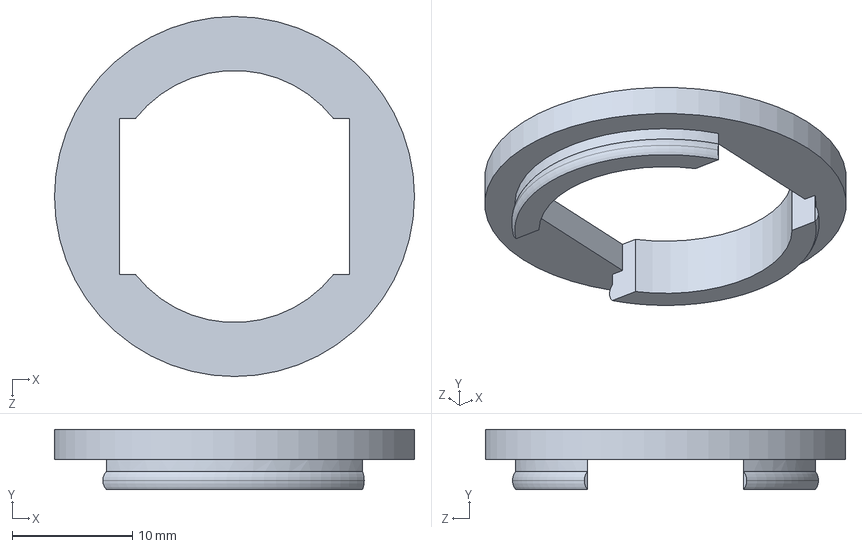
[picture p107: CAD file, 2021-07-06]
Physical_System/Solidworks_Parts/Holonomic car/HoleSwitchV2.SLDPRT
30.0 x 5.00 x 30.0 mm
