fontysrobotics/DCRC/Physical_System/Solidworks_Parts/CoLAB/HoleSwitchV1.SLDPRT

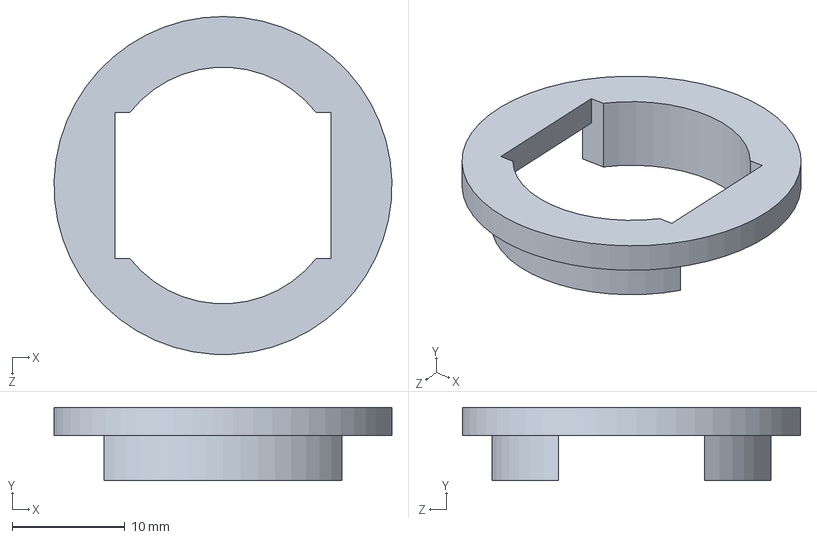
[picture p108: CAD file, 2021-07-06]
Physical_System/Solidworks_Parts/CoLAB/HoleSwitchV1.SLDPRT
30.0 x 6.50 x 30.0 mm
