fontysrobotics/DCRC/(list of files, cad)

Other CAD files:
catkin_ws/src/simulation/simenv/worlds/aa(2).stl
catkin_ws/src/simulation/turtlebot3_description/meshes/wheels/right_tire.stl
Physical_System/Solidworks_Parts/CoLAB/raspberry-pi-4-model-b-1.snapshot.3/Camera Connector, RPi4ModelB.SLDPRT
Physical_System/Solidworks_Parts/CoLAB/30mm-dc-fan-1.snapshot.6/30X30X10 DC fan.SLDPRT
Physical_System/Solidworks_Parts/CoLAB/5mm-led-grommit-1.snapshot.1/5mm LED GROMMIT.SLDPRT
Physical_System/Solidworks_Parts/CoLAB/AAA battery holder/AAA-battery-x4-case.SLDPRT
Physical_System/Solidworks_Parts/CoLAB/AAA battery holder/AAA-battery-x4-case.f3d
Physical_System/Solidworks_Parts/CoLAB/m12-cable-gland-1.snapshot.1/gland_m12.SLDPRT
