fontysrobotics/DCRC/Wiki-Pictures/CoLAB electric setup.jpg

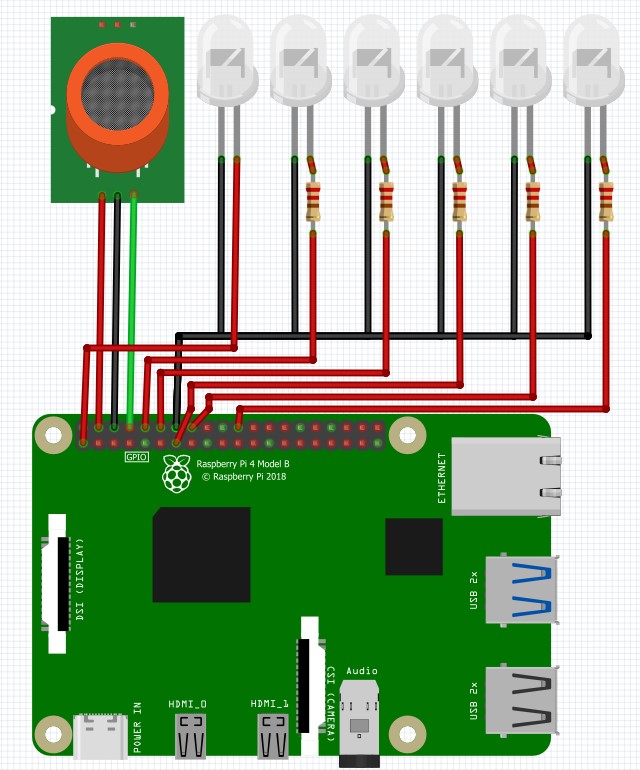
Wiki-Pictures/CoLAB electric setup.jpg
