fontysrobotics/DCRC/Wiki-Pictures/Hollonomic electric setup.jpg

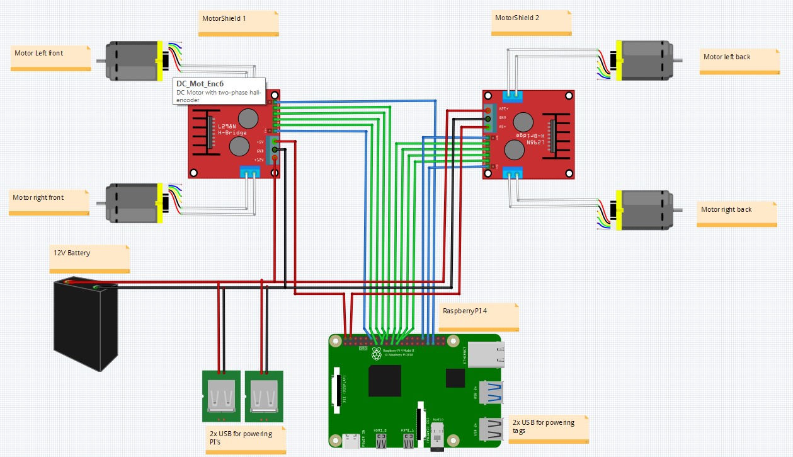
Wiki-Pictures/Hollonomic electric setup.jpg
