fontysrobotics/DCRC/Wiki-Pictures/Network setup robots.png

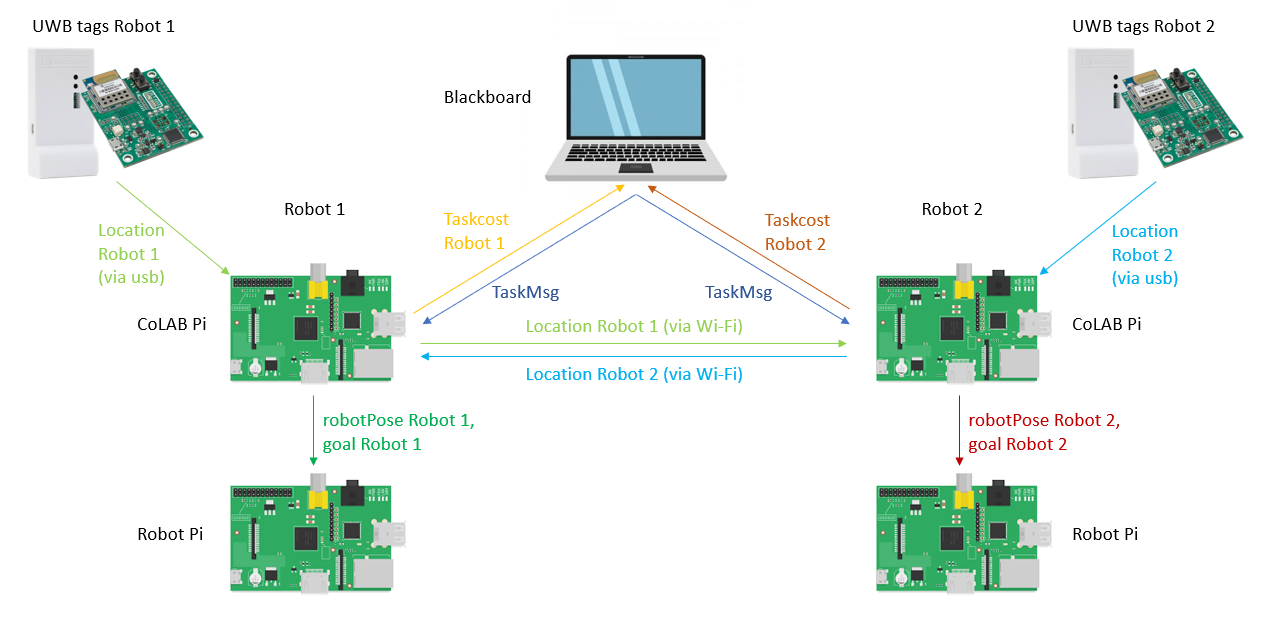
Wiki-Pictures/Network setup robots.png
