fontysrobotics/DCRC/Wiki-Pictures/UWB_Tag_Setup2.jpeg

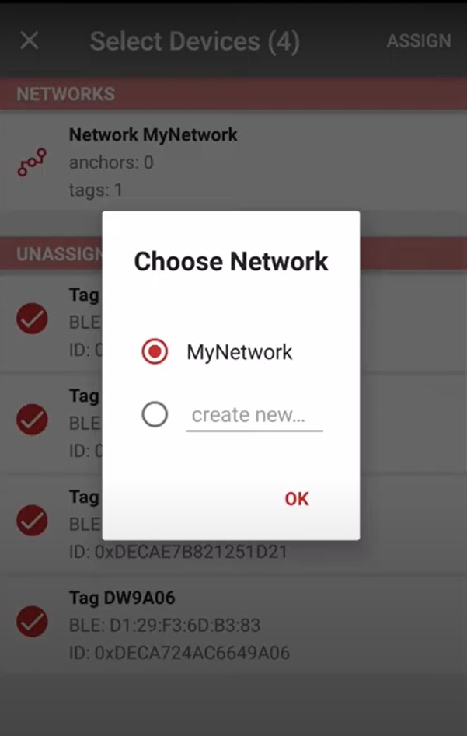
Wiki-Pictures/UWB_Tag_Setup2.jpeg
