fontysrobotics/DCRC/Wiki-Pictures/UWB_Tag_Setup3.jpeg

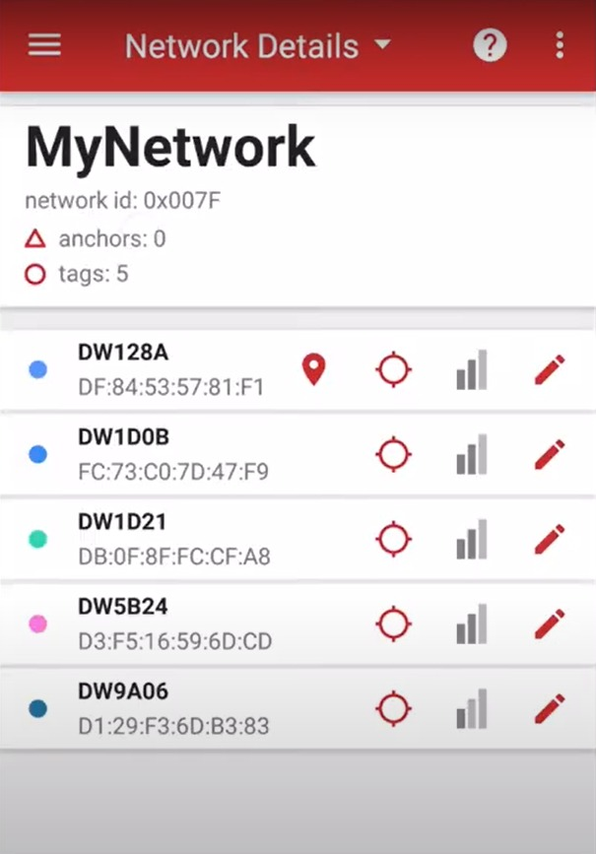
Wiki-Pictures/UWB_Tag_Setup3.jpeg
