fontysrobotics/DCRC/Wiki-Pictures/UWB_Tag_Setup4.jpeg

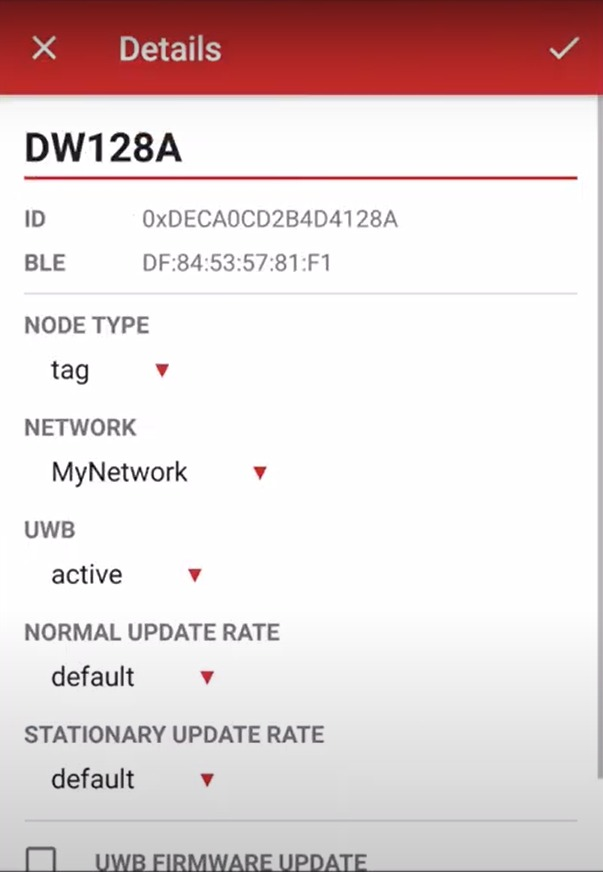
Wiki-Pictures/UWB_Tag_Setup4.jpeg
