fontysrobotics/DCRC/Wiki-Pictures/UWB_Tag_Setup5.jpeg

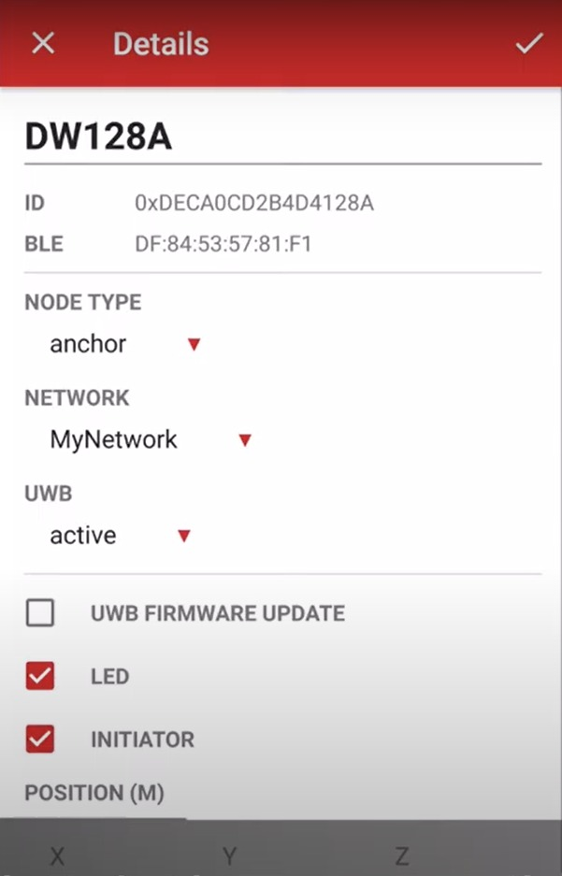
Wiki-Pictures/UWB_Tag_Setup5.jpeg
