fontysrobotics/DCRC/Wiki-Pictures/UWB_Tag_Setup.jpeg

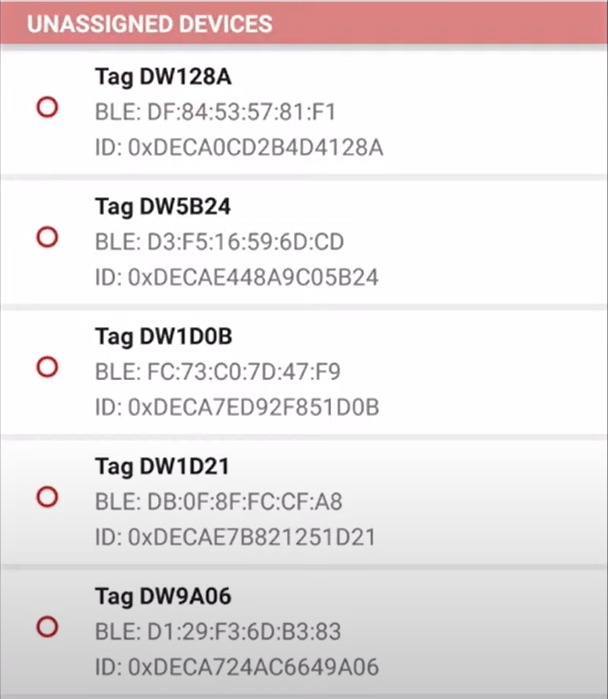
Wiki-Pictures/UWB_Tag_Setup.jpeg
