fontysrobotics/DCRC/(list of files, drawings)

Other design files:
Physical_System/Electric_schematics/colab elec.fzz
Physical_System/Electric_schematics/Electrical schematic holonomic platform.fzz
