fontysrobotics/DCRC/Physical_System/PCB_design/PCB_CoLAB_Schematic_V2.brd

## EAGLE design Physical_System/PCB_design/PCB_CoLAB_Schematic_V2.brd (2021-07-06)

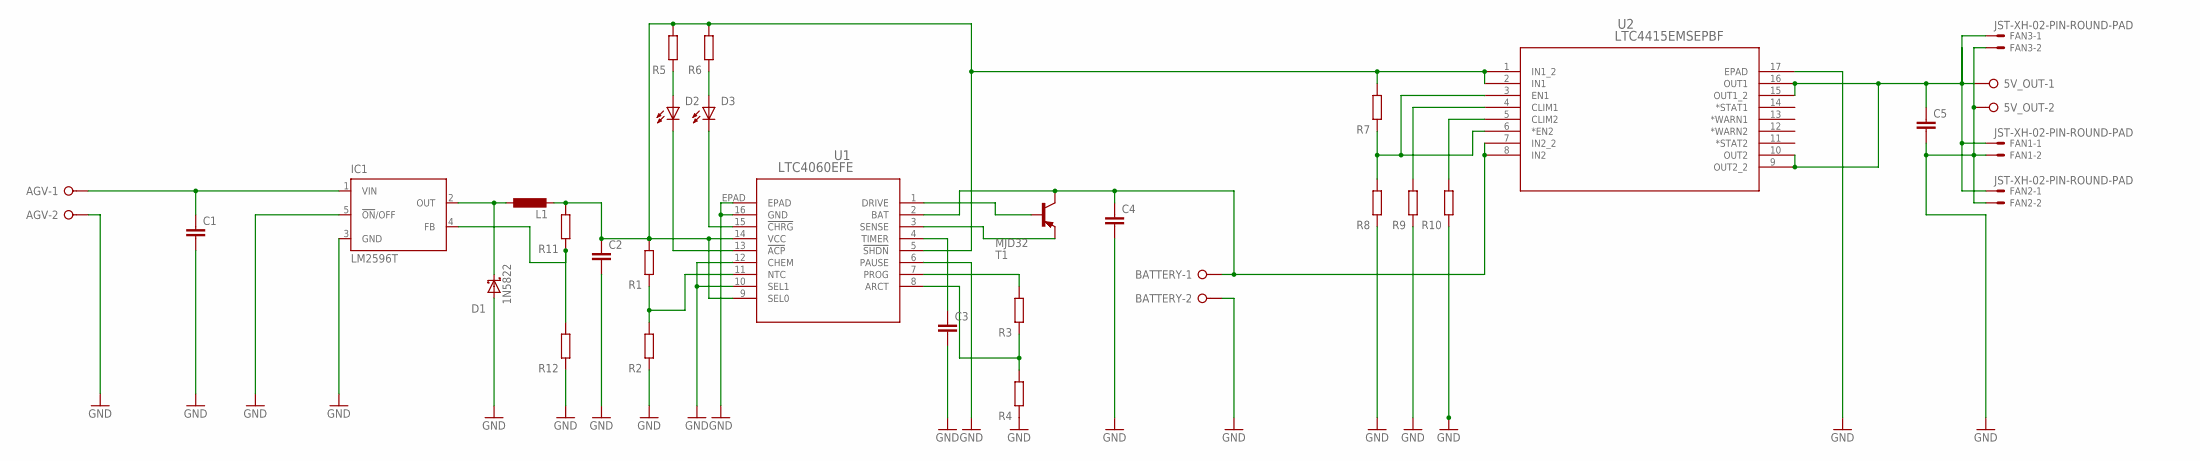
[picture p135: schematic PCB_CoLAB_Schematic_V2.sch]

Parts:
5V_OUT: W237-02P; W237-132
AGV: W237-02P; W237-132
BATTERY: W237-02P; W237-132
C1: C-EU050-075X075; C050-075X075
C2: C-EU025-050X050; C025-050X050
C3, C5: C-EU025-024X044; C025-024X044
C4: C-EU050-050X075; C050-050X075
D1: 1N5822; DIOAD2120W130L950D530P
D2, D3: LED_ELD260; LED_LD260
FAN1, FAN2, FAN3: JST-XH-02-PIN-ROUND-PAD; JST-XH-02-PACKAGE-ROUND-PAD
IC1: LM2596T; T05D
L1: L-EU0204/7; 0204/7
R1, R2, R3, R4, R5, R6, R7, R8, R9, R10, R11, R12: R0204/7; 0204/7
T1: MJD32; DPAK
U1: LTC4060EFE; TSSOP-16_FE/BC_LIT
U2: LTC4415EMSEPBF; MSOP-16_MSE

Connections:
GND: 5V_OUT.2, AGV.2, BATTERY.2, C1.2, C2.2, C3.2, C4.2, C5.2, D1.A, FAN1.2, FAN2.2, FAN3.2, IC1.3 (GND), IC1.5 (!ON!/OFF), R2.1, R4.1, R8.1, R9.1, R10.1, R12.1, U1.6 (PAUSE), U1.10 (SEL1), U1.12 (CHEM), U1.16 (GND), U1.EPAD, U2.17 (EPAD)
unnamed: R3.2, U1.7 (PROG)
unnamed: AGV.1, C1.1, IC1.1 (VIN)
unnamed: D1.C, IC1.2 (OUT), L1.1
unnamed: R1.1, R2.2, U1.11 (NTC)
unnamed: R7.1, R8.2, U2.3 (EN1), U2.6 (*EN2)
unnamed: R3.1, R4.2, U1.8 (ARCT)
unnamed: T1.3 (E), U1.3 (SENSE)
unnamed: T1.1 (B), U1.1 (DRIVE)
unnamed: C2.1, L1.2, R1.2, R5.2, R6.2, R7.2, R11.2, U1.5 (!SHDN), U1.9 (SEL0), U1.14 (VCC), U2.1 (IN1_2), U2.2 (IN1)
unnamed: C3.1, U1.4 (TIMER)
unnamed: D2.A, R5.1
unnamed: D2.K (C), U1.13 (!ACP)
unnamed: D3.K (C), U1.15 (!CHRG)
unnamed: D3.A, R6.1
unnamed: BATTERY.1, C4.1, T1.4 (C), U1.2 (BAT), U2.7 (IN2_2), U2.8 (IN2)
unnamed: R9.2, U2.4 (CLIM1)
unnamed: R10.2, U2.5 (CLIM2)
unnamed: 5V_OUT.1, C5.1, FAN1.1, FAN2.1, FAN3.1, U2.9 (OUT2_2), U2.10 (OUT2), U2.15 (OUT1_2), U2.16 (OUT1)
unnamed: IC1.4 (FB), R11.1, R12.2

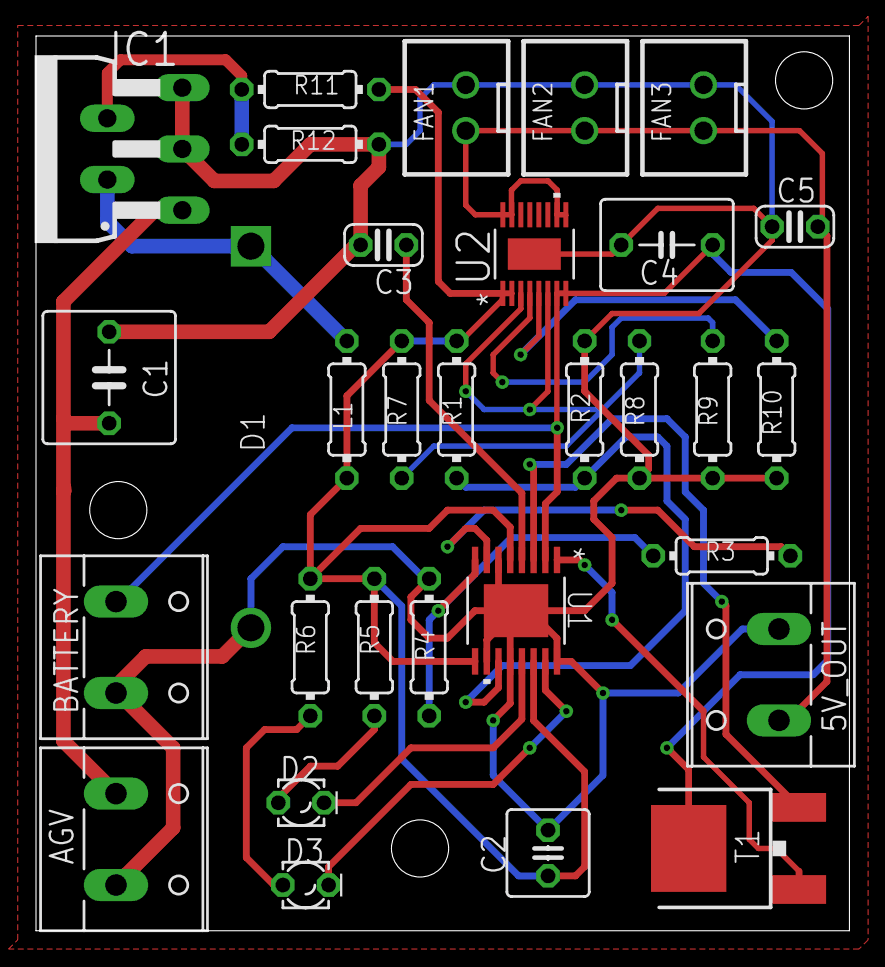
[picture p136: board PCB_CoLAB_Schematic_V2.brd from above]

Board: 2 copper layers, 45.2 x 49.7 mm, 31 parts (1 on the bottom side), 20 nets.
