fontysrobotics/DCRC/CoLabSoftware/TCPServer.py

import socketserver, pickle
from CoLAB_main import AGVMap
from CoLAB_sendLocation import preProcessedLocation,preProcessedOrientation

class TCPServer(socketserver.BaseRequestHandler):
    def handle(self):
        data = self.request.recv(1024).strip()
        if data == b'List':
            self.request.sendall(pickle.dumps(AGVMap))
        elif data == b'Preprocessed':
            toSend = [preProcessedLocation,preProcessedOrientation]
            self.request.sendall(pickle.dumps(toSend))
        else:
            self.request.sendall(b'Default')
        
if __name__ == "__main__":
    HOST, PORT = "145.93.68.114", 9999
    server = socketserver.TCPServer((HOST, PORT), TCPServer)
    server.serve_forever()
    
    
