fontysrobotics/DCRC/(commit log)

2021-06-16 init blackboard
    [aa(2).stl, box_mesh.stl, common_properties.xacro, en.stl, fuze_bottle_collision.stl, lds.stl, left_tire.stl, model.sdf]
2021-06-23 lidar subscription
2021-06-25 robot navigation restructuring & obstacle avoidance basics
    [Controller.py, Robot.py, TCPClient.py]
